JohnHurley16/RoboArm/docs/images/actuator_section.png

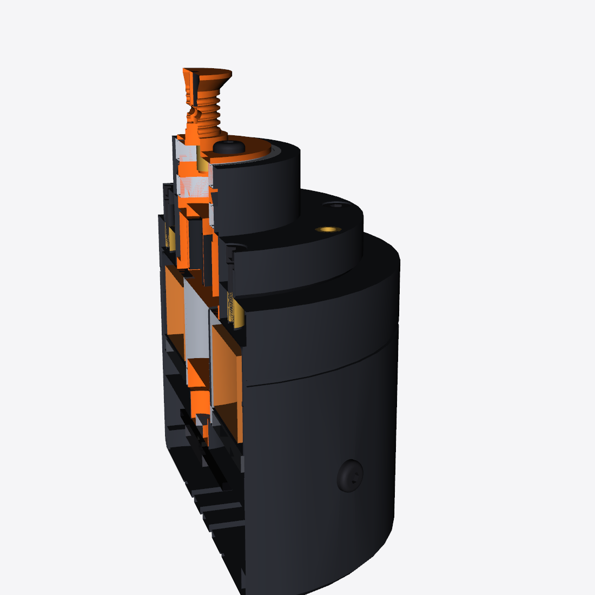
docs/images/actuator_section.png
