JohnHurley16/RoboArm/docs/images/balancer_cutaway.png

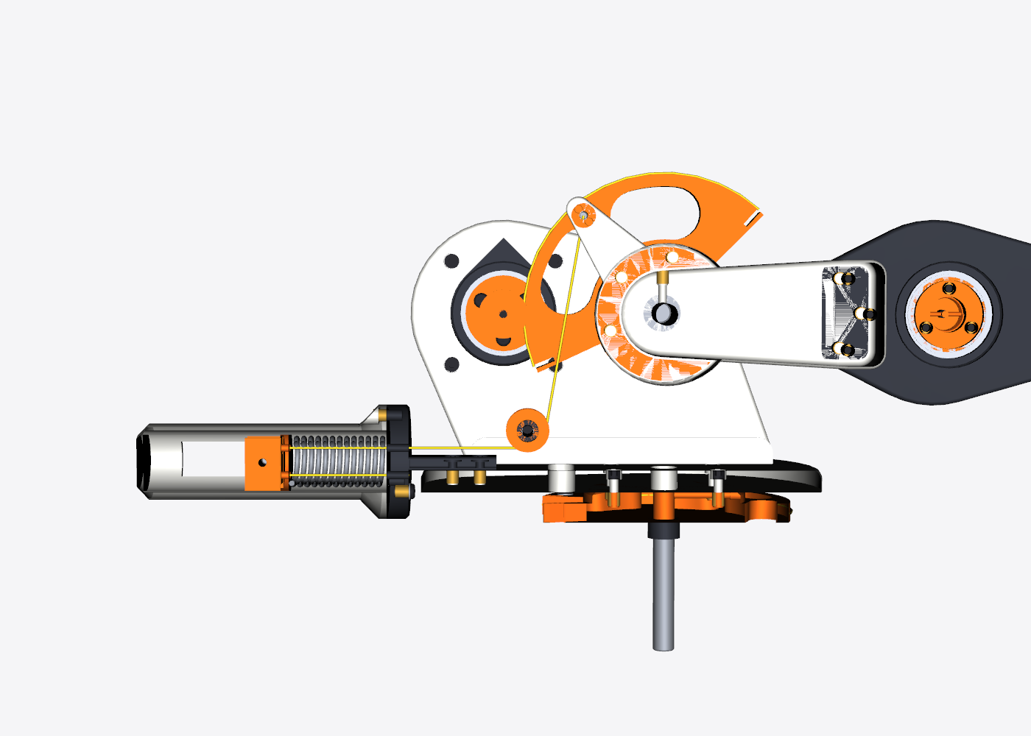
docs/images/balancer_cutaway.png
