JohnHurley16/RoboArm/docs/images/final_pose_back.png

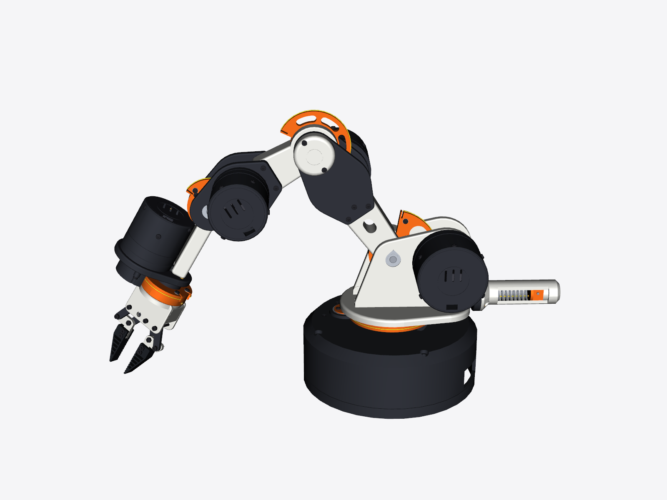
docs/images/final_pose_back.png
