JohnHurley16/RoboArm/docs/images/hand_open.png

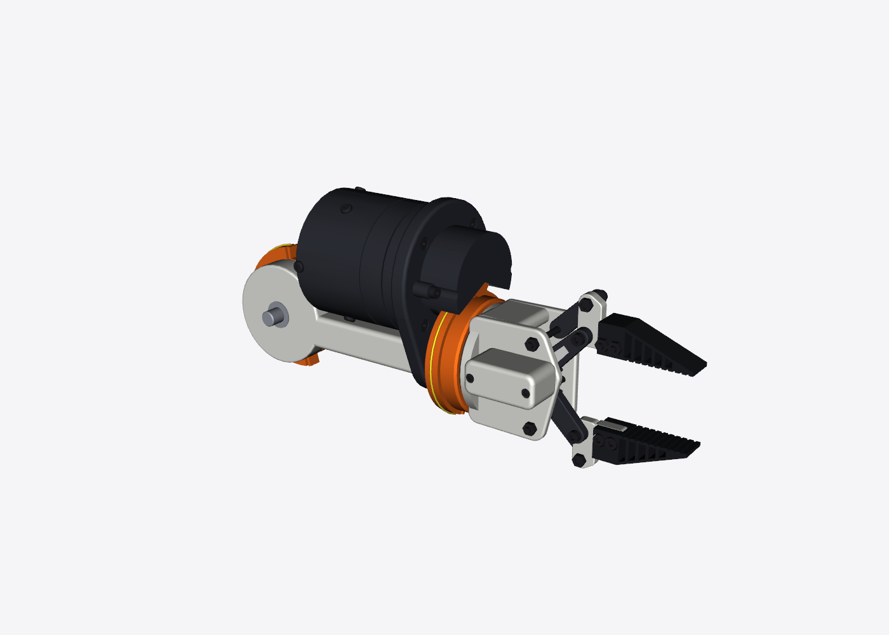
docs/images/hand_open.png
