JohnHurley16/RoboArm/docs/images/hand_rolled.png

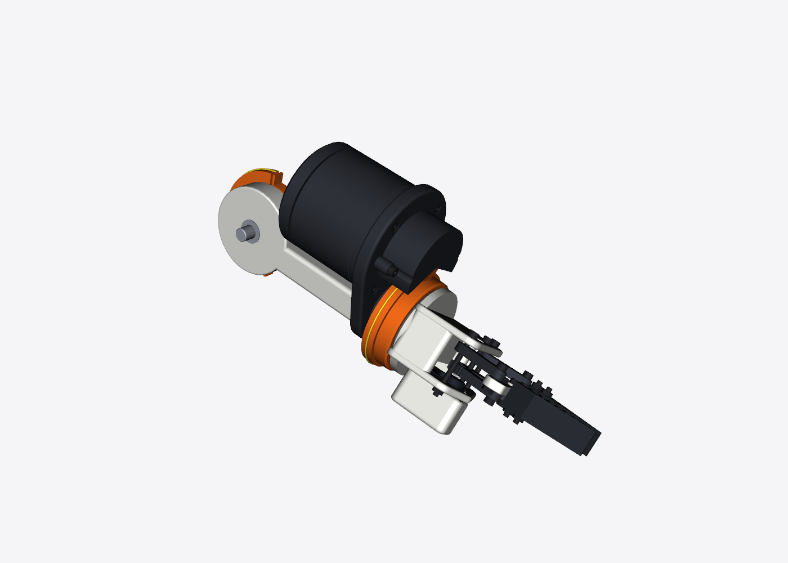
docs/images/hand_rolled.png
