JohnHurley16/RoboArm/print/plates/plates_overview.png

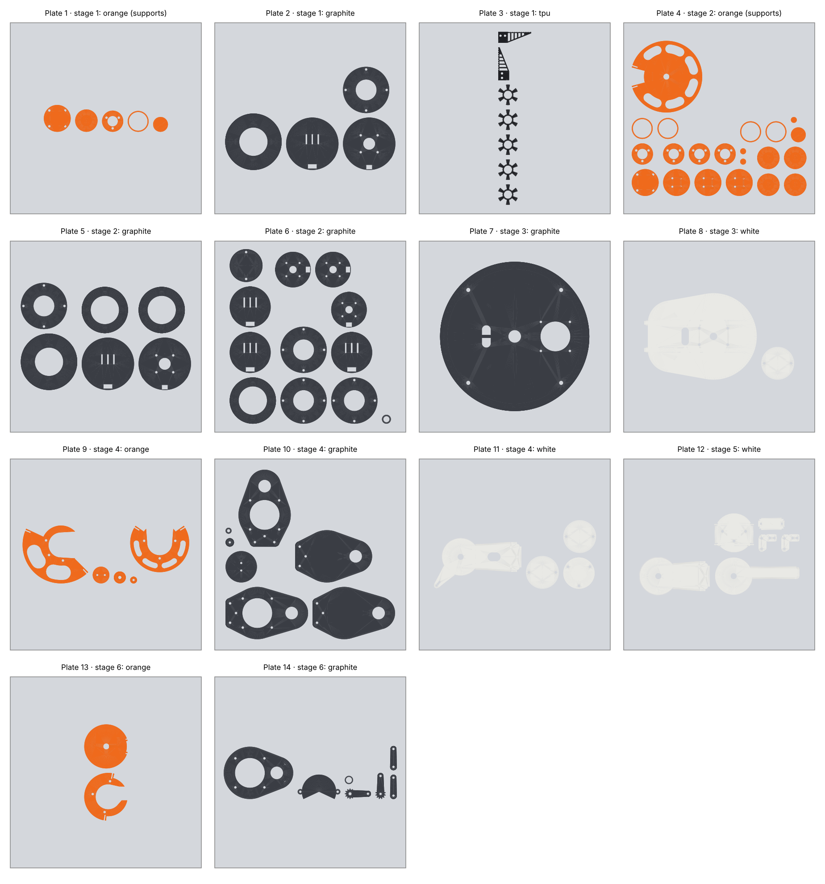
print/plates/plates_overview.png
