JohnHurley16/RoboArm/sim/out/bag_drape.png

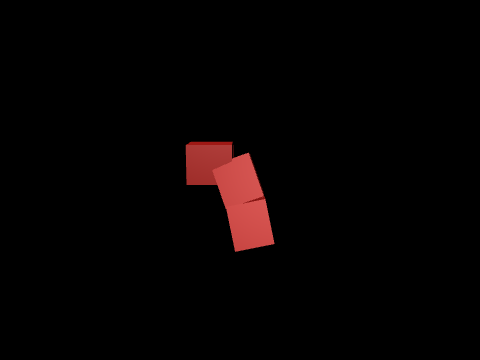
sim/out/bag_drape.png
