JohnHurley16/RoboArm/sim/out/bag_rest.png

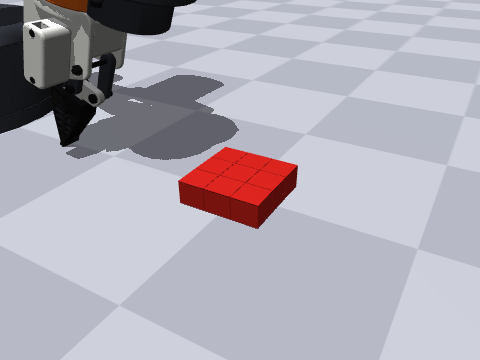
sim/out/bag_rest.png
