JohnHurley16/RoboArm/sim/out/model_check.png

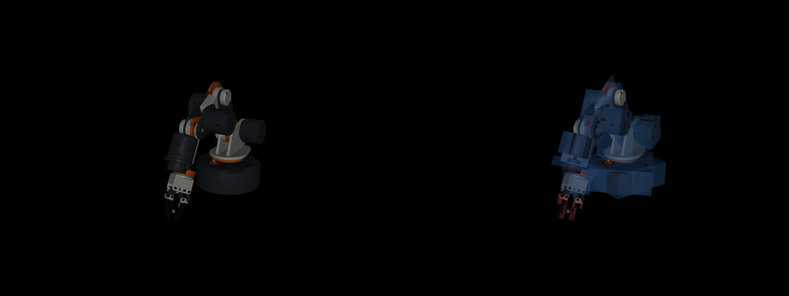
sim/out/model_check.png
