JohnHurley16/RoboArm/sim/out/pick_frames.png

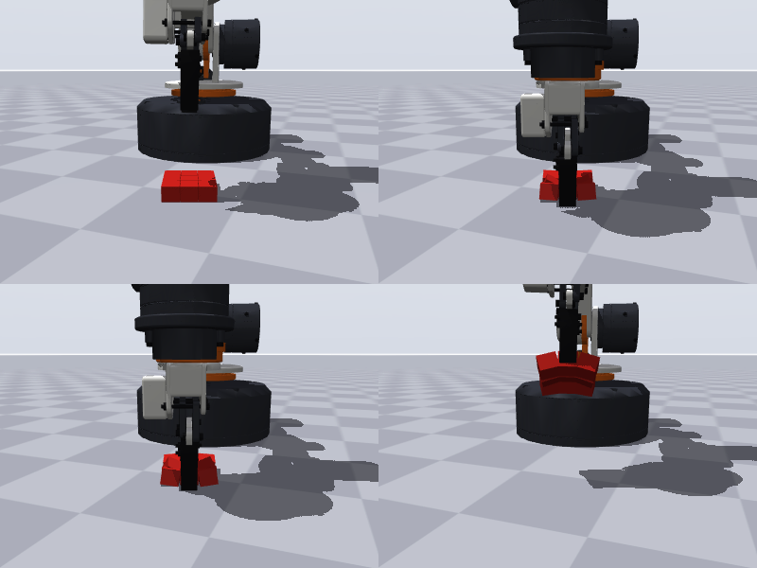
sim/out/pick_frames.png
