JohnHurley16/RoboArm/docs/BOM.md

# Bill of materials

## Printed parts

| Part | Qty | Bounding box (print orientation, mm) | Overhang >45° (mm²) |
|---|---:|---|---:|
| `base.stl` | 1 | 200 × 200 × 72 | 4209 |
| `act_front_cap.stl` | 5 | 62 × 62 × 20 | 394 |
| `act_motor_can_GL40.stl` | 3 | 62 × 62 × 52 | 231 |
| `act_rear_plate_GL40.stl` | 3 | 48 × 48 × 8 | 51 |
| `act_rear_lid_GL40.stl` | 3 | 55 × 55 × 6 | 130 |
| `act_hub.stl` | 5 | 30 × 30 × 38 | 663 |
| `act_rotor_adapter_GL40.stl` | 3 | 36 × 36 × 13 | 27 |
| `act_spider_tpu.stl` | 5 | 26 × 27 × 10 | 0 |
| `act_retainer_ring.stl` | 5 | 28 × 28 × 1 | 0 |
| `act_bearing_spacer.stl` | 5 | 28 × 28 × 3 | 0 |
| `act_magnet_plug_GL40.stl` | 3 | 8 × 8 × 12 | 0 |
| `joint_cap.stl` | 4 | 44 × 44 × 14 | 280 |
| `turret_drum.stl` | 1 | 94 × 96 × 11 | 66 |
| `turret_body.stl` | 1 | 151 × 116 × 100 | 188 |
| `j1_spacer.stl` | 1 | 12 × 12 × 7 | 0 |
| `act_motor_can_GL60.stl` | 2 | 76 × 76 × 53 | 244 |
| `act_rear_plate_GL60.stl` | 2 | 70 × 70 × 8 | 60 |
| `act_rear_lid_GL60.stl` | 2 | 70 × 70 × 6 | 130 |
| `act_rotor_adapter_GL60.stl` | 2 | 36 × 36 × 13 | 17 |
| `act_magnet_plug_GL60.stl` | 2 | 20 × 20 × 12 | 0 |
| `balancer_idler.stl` | 1 | 16 × 16 × 5 | 72 |
| `balancer_spacer.stl` | 1 | 8 × 8 × 4 | 0 |
| `balancer_bracket.stl` | 1 | 42 × 42 × 40 | 75 |
| `balancer_tube.stl` | 1 | 42 × 42 × 92 | 392 |
| `upper_arm.stl` | 1 | 118 × 69 × 27 | 191 |
| `balancer_spool.stl` | 1 | 9 × 9 × 3 | 43 |
| `sector_j2.stl` | 1 | 88 × 78 × 7 | 0 |
| `upper_arm_cheek_a.stl` | 1 | 111 × 70 × 9 | 141 |
| `upper_arm_cheek_b.stl` | 1 | 111 × 70 × 9 | 166 |
| `forearm.stl` | 1 | 95 × 52 × 27 | 179 |
| `sector_j3.stl` | 1 | 62 × 79 × 7 | 0 |
| `forearm_cheek_a.stl` | 1 | 103 × 70 × 9 | 137 |
| `forearm_cheek_b.stl` | 1 | 103 × 70 × 9 | 162 |
| `hand.stl` | 1 | 114 × 52 × 27 | 246 |
| `sector_j4.stl` | 1 | 58 × 64 × 7 | 0 |
| `wrist_yoke.stl` | 1 | 93 × 70 × 22 | 98 |
| `roll_pulley_guard.stl` | 1 | 33 × 57 × 20 | 56 |
| `roll_spacer.stl` | 1 | 11 × 11 × 7 | 0 |
| `roll_flange.stl` | 1 | 58 × 59 × 15 | 875 |
| `palm.stl` | 1 | 53 × 52 × 47 | 330 |
| `servo_cover.stl` | 1 | 35 × 16 × 20 | 103 |
| `link_drive_upper.stl` | 1 | 35 × 14 × 5 | 0 |
| `link_drive_lower.stl` | 1 | 35 × 14 × 5 | 0 |
| `link_follow.stl` | 2 | 33 × 9 × 5 | 0 |
| `finger.stl` | 2 | 25 × 24 × 5 | 0 |
| `finray_tpu.stl` | 2 | 44 × 15 × 14 | 102 |
| `balancer_piston.stl` | 1 | 22 × 22 × 16 | 7 |
| `balancer_piston_pulley.stl` | 1 | 11 × 11 × 3 | 11 |

Estimated filament: ~1111 g PETG (4 walls, 25-35 % gyroid).

## Purchased parts

| Item | Qty |
|---|---:|
| 608 bearing (8x22x7) | 10 |
| 6705 bearing (25x32x4) | 10 |
| 684ZZ bearing (4x9x4) | 1 |
| 8 mm e-clip (DIN 6799) | 1 |
| 8 mm steel shaft x 30 mm | 1 |
| 8 mm steel shaft x 44 mm (h6 / linear rod) | 3 |
| 8 mm steel shaft x 60 mm | 1 |
| AS5047P encoder breakout (joint encoder, to the driver aux port) | 4 |
| Compression spring, music wire 2.2 mm, OD 21 mm, free length 78 mm, ~3.2 N/mm, ends closed & ground | 1 |
| CubeMars GL40 KV70 | 3 |
| CubeMars GL60 KV25 | 2 |
| Diametric magnet 6x2.5 mm | 4 |
| Dowel pin 3x12 (piston pulley) | 1 |
| Dowel pin 3x8 (balancer ear) | 1 |
| M2 heat-set insert | 20 |
| M2.5x5 button head (rotor adapter; check max depth on the drawing) | 12 |
| M2.5x6 socket head (motor to plate; check max depth on the drawing) | 12 |
| M2x20 self-tapping screw (servo) | 2 |
| M2x5 socket head (driver) | 20 |
| M2x6 self-tapping screw (encoder board) | 8 |
| M3 heat-set insert (M3x5.7, 4.6 OD) | 145 |
| M3 nyloc nut | 11 |
| M3 washer (cable clamp) | 11 |
| M3x10 socket head | 38 |
| M3x10 socket head (actuator mount) | 20 |
| M3x12 socket head | 2 |
| M3x12 socket head (finger pin) | 4 |
| M3x16 socket head (fingertip) | 4 |
| M3x16 socket head (joint cap) | 8 |
| M3x35 socket head (palm pivot) | 3 |
| M3x5 button head (rotor adapter; check max depth on the drawing) | 8 |
| M3x6 button head (cable clamp) | 11 |
| M3x6 button head (can) | 30 |
| M3x6 button head (retainer) | 15 |
| M3x6 grub screw (pulley cable clamp) | 5 |
| M3x6 socket head (motor to plate; check max depth on the drawing) | 8 |
| M3x8 button head | 5 |
| M3x8 grub screw (shaft lock) | 4 |
| M3x8 socket head | 3 |
| M3x8 socket head (sector) | 9 |
| M4 nyloc nut | 1 |
| M4x20 socket head (balancer idler) | 1 |
| M8 shim washer 8x14x0.5 | 7 |
| MG90S metal-gear micro servo | 1 |
| mjbots moteus-c1 motor driver | 5 |
| Dyneema / UHMWPE braid Ø1 mm, J1: 501 mm (incl. 2×40 mm tails) | 1 |
| Dyneema / UHMWPE braid Ø1 mm, J2: 367 mm (incl. 2×40 mm tails) | 1 |
| Dyneema / UHMWPE braid Ø1 mm, J3: 396 mm (incl. 2×40 mm tails) | 1 |
| Dyneema / UHMWPE braid Ø1 mm, J4: 329 mm (incl. 2×40 mm tails) | 1 |
| Dyneema / UHMWPE braid Ø1 mm, J5: 394 mm (incl. 2×40 mm tails) | 1 |
| Dyneema / UHMWPE braid Ø1 mm, shoulder balancer: 410 mm (incl. tails) | 1 |
