JohnHurley16/RoboArm/print/step/arm_assembly.step

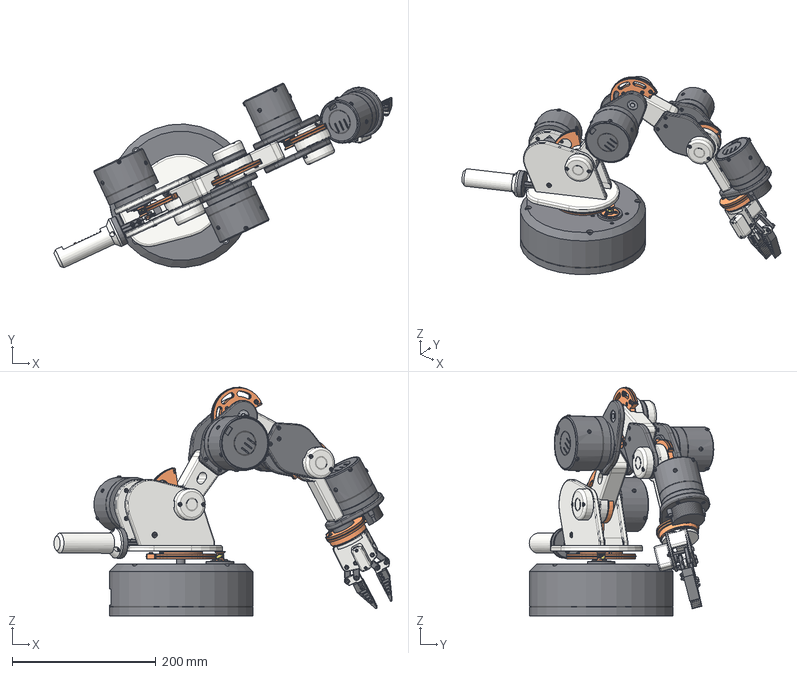
[picture p13: CAD file, 2026-10-08]
print/step/arm_assembly.step
470.5 x 257.0 x 318.3 mm
base__base__0
base__act_front_cap__1 x 3
base__act_motor_can_GL40__2 x 3
base__act_rear_plate_GL40__3 x 3
base__act_rear_lid_GL40__4 x 3
base__act_hub__5 x 3
base__act_rotor_adapter_GL40__6 x 3
base__act_spider_tpu__7 x 3
base__act_retainer_ring__8 x 3
base__act_bearing_spacer__9 x 3
base__act_magnet_plug_GL40__10 x 3
base__motor_base__11 x 3
base__motor_bell__12 x 3
base__motor_shaft__13 x 3
base__motor_stator__14 x 3
base__motor_wires__15 x 3
base__drv_pcb__16 x 3
base__drv_parts__17 x 3
base__drv_chip__18 x 3
base__magnet_drv__19 x 3
base__brg_6705__20 x 3
base__brg_6705__21 x 3
base__ins_m3__22 x 3
base__shcs_m3x10__23 x 3
base__ins_m3__24 x 3
base__shcs_m3x10__25 x 3
base__ins_m3__26 x 3
base__shcs_m3x10__27 x 3
base__ins_m3__28 x 3
base__shcs_m3x10__29 x 3
base__ins_m3__30 x 3
base__ins_m3__31 x 3
base__ins_m3__32 x 3
base__ins_m3__33 x 3
base__ins_m3__34 x 3
base__bhcs_m3x6__35 x 3
base__ins_m3__36 x 3
base__bhcs_m3x6__37 x 3
base__ins_m3__38 x 3
base__bhcs_m3x6__39 x 3
base__grub_m3x6__40 x 3
base__ins_m3__41 x 3
base__bhcs_m3x6__42 x 3
base__ins_m3__43 x 3
base__bhcs_m3x6__44 x 3
base__ins_m3__45 x 3
base__bhcs_m3x6__46 x 3
base__ins_m3__47 x 3
base__bhcs_m3x6__48 x 3
base__ins_m3__49 x 3
base__bhcs_m3x6__50 x 3
base__ins_m3__51 x 3
base__bhcs_m3x6__52 x 3
base__motor_screw__53 x 3
base__motor_screw__54 x 3
base__motor_screw__55 x 3
base__motor_screw__56 x 3
base__motor_screw__57 x 3
base__motor_screw__58 x 3
base__motor_screw__59 x 3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
