JohnHurley16/RoboArm/print/mini/capstan_arm_mini.3mf

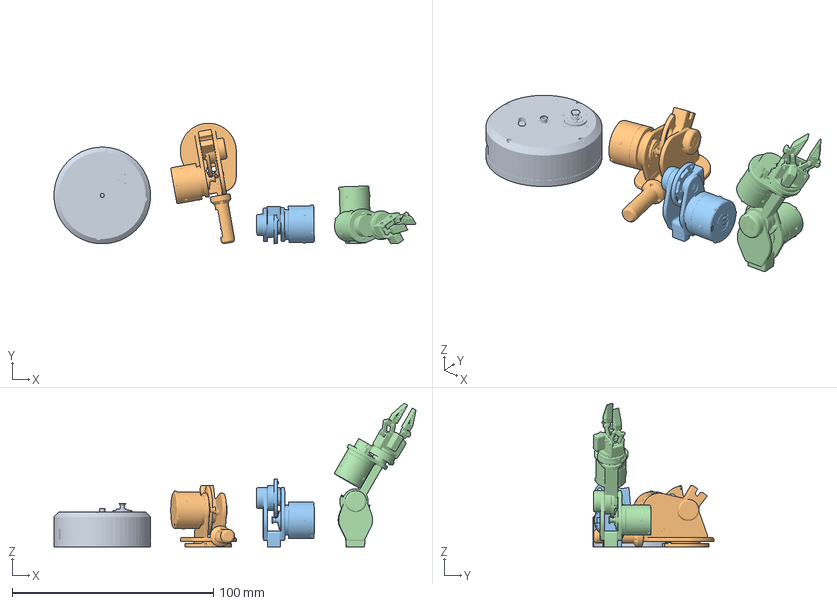
[picture p14: CAD file, 2026-10-08]
print/mini/capstan_arm_mini.3mf
179.9 x 59.9 x 71.3 mm
A_base
B_shoulder
C_elbow
D_wrist
