JohnHurley16/RoboArm/print/plates/plate_07_s3_graphite.3mf

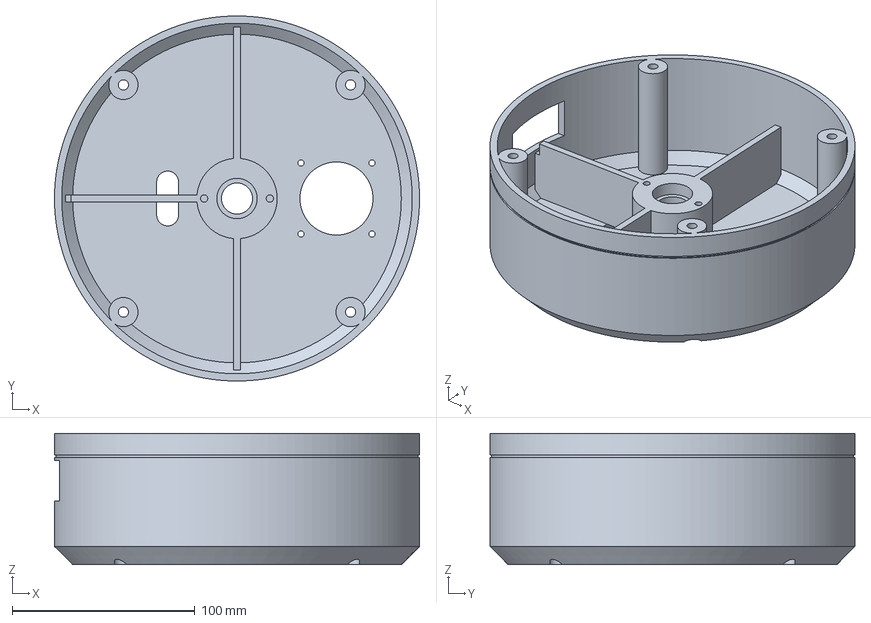
[picture p15: CAD file, 2026-10-08]
print/plates/plate_07_s3_graphite.3mf
200.0 x 199.9 x 72.0 mm
