JohnHurley16/RoboArm/print/stl/roll_flange.stl

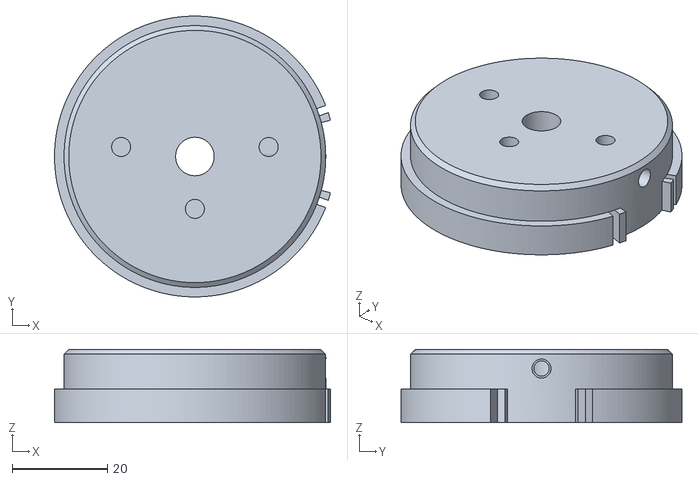
[picture p17: CAD file, 2026-10-08]
print/stl/roll_flange.stl
58.0 x 59.0 x 15.4
