JohnHurley16/RoboArm/sim/assets/meshes/l1u_graphite.stl

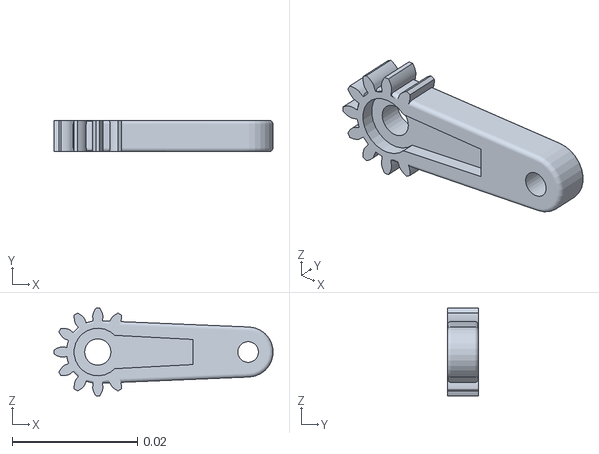
[picture p18: CAD file, 2026-10-08]
sim/assets/meshes/l1u_graphite.stl
0.035 x 0.005 x 0.014
