JohnHurley16/RoboArm/print/plates/plate_04_s2_orange_supports.3mf

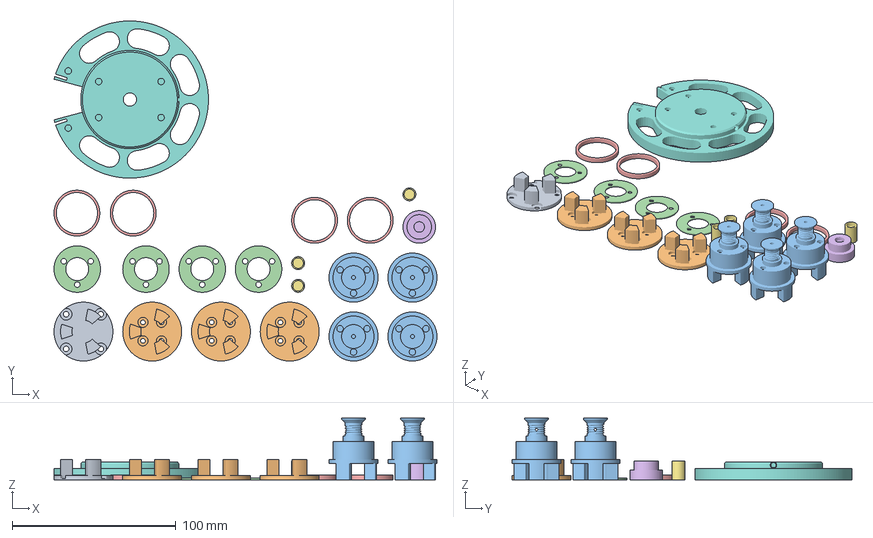
[picture p19: CAD file, 2026-10-08]
print/plates/plate_04_s2_orange_supports.3mf
234.0 x 207.8 x 37.6 mm
act_rotor_adapter_GL60
act_rotor_adapter_GL40 x 3
act_hub x 4
act_retainer_ring x 4
act_bearing_spacer x 4
act_magnet_plug_GL60
act_magnet_plug_GL40 x 3
turret_drum
