JohnHurley16/RoboArm/print/stl/act_magnet_plug_GL40.stl

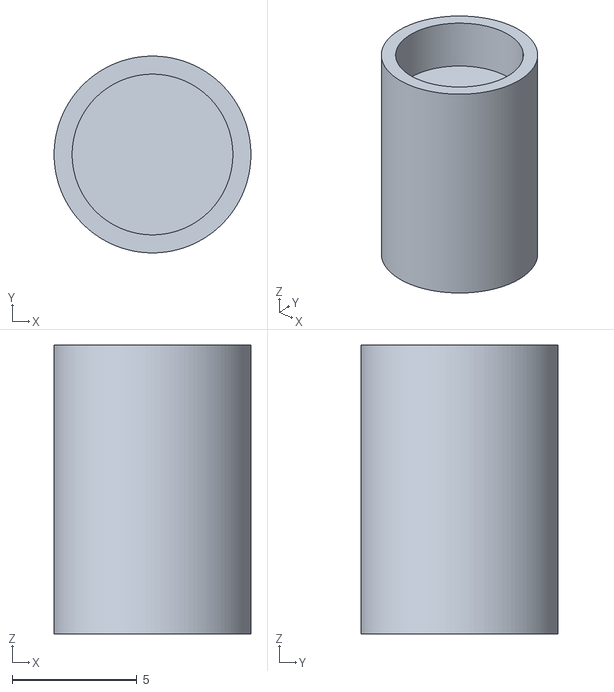
[picture p20: CAD file, 2026-10-08]
print/stl/act_magnet_plug_GL40.stl
7.90 x 7.90 x 11.6
