JohnHurley16/RoboArm/sim/assets/meshes/hand_steel.stl

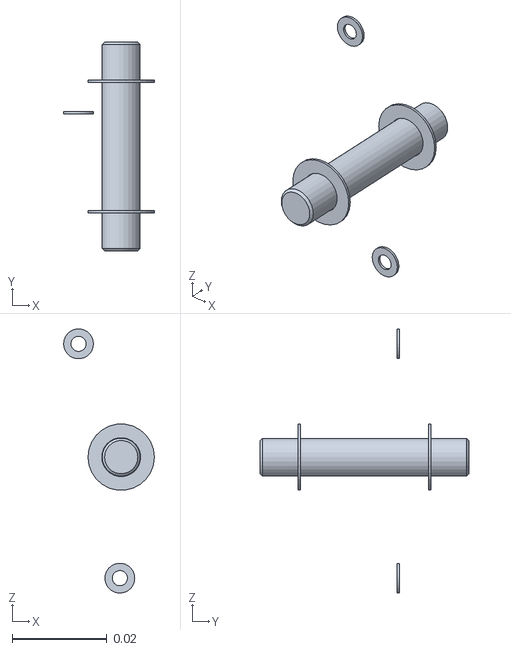
[picture p21: CAD file, 2026-10-08]
sim/assets/meshes/hand_steel.stl
0.0191 x 0.044 x 0.0556
