JohnHurley16/RoboArm/print/plates/plate_13_s6_orange.3mf

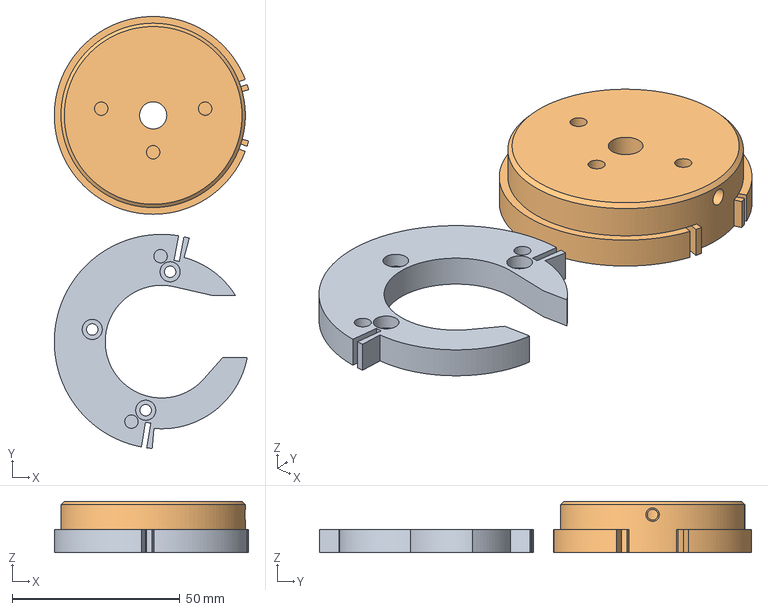
[picture p22: CAD file, 2026-10-08]
print/plates/plate_13_s6_orange.3mf
58.0 x 128.9 x 15.3 mm
sector_j4
roll_flange
