JohnHurley16/RoboArm/print/step/actuator_GL60.step

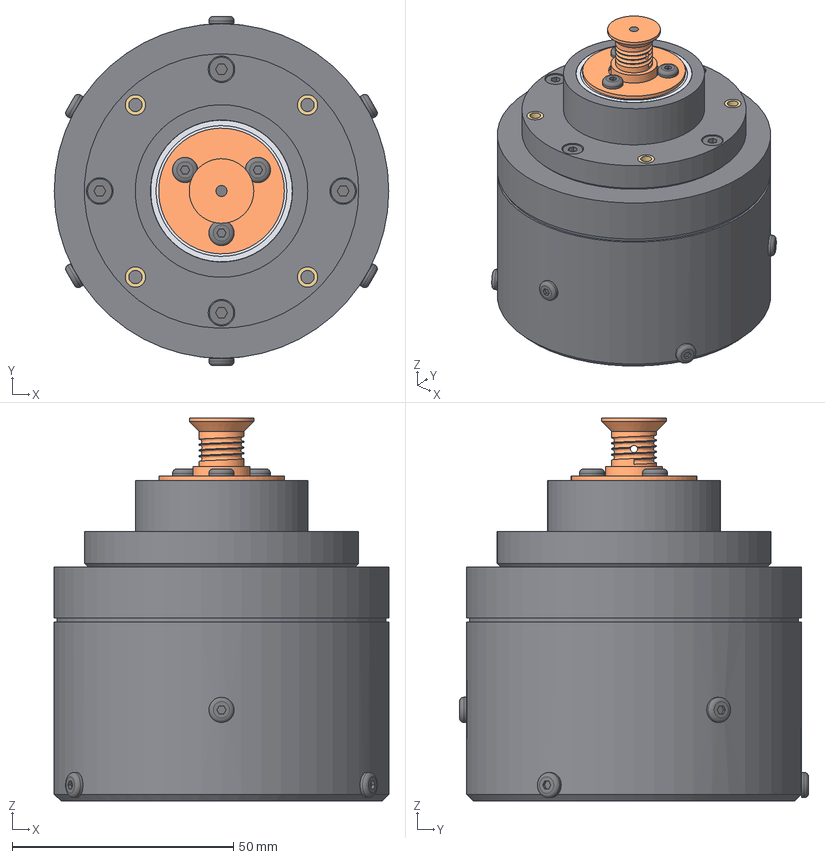
[picture p23: CAD file, 2026-10-08]
print/step/actuator_GL60.step
75.6 x 78.9 x 86.5 mm
act_front_cap__0
act_motor_can_GL60__1
act_rear_plate_GL60__2
act_rear_lid_GL60__3
act_hub__4
act_rotor_adapter_GL60__5
act_spider_tpu__6
act_retainer_ring__7
act_bearing_spacer__8
act_magnet_plug_GL60__9
motor_base__10
motor_bell__11
motor_shaft__12
motor_stator__13
motor_wires__14
drv_pcb__15
drv_parts__16
drv_chip__17
magnet_drv__18
brg_6705__19
brg_6705__20
ins_m3__21
shcs_m3x10__22
ins_m3__23
shcs_m3x10__24
ins_m3__25
shcs_m3x10__26
ins_m3__27
shcs_m3x10__28
ins_m3__29
ins_m3__30
ins_m3__31
ins_m3__32
ins_m3__33
bhcs_m3x6__34
ins_m3__35
bhcs_m3x6__36
ins_m3__37
bhcs_m3x6__38
grub_m3x6__39
ins_m3__40
bhcs_m3x6__41
ins_m3__42
bhcs_m3x6__43
ins_m3__44
bhcs_m3x6__45
ins_m3__46
bhcs_m3x6__47
ins_m3__48
bhcs_m3x6__49
ins_m3__50
bhcs_m3x6__51
motor_screw__52
motor_screw__53
motor_screw__54
motor_screw__55
motor_screw__56
motor_screw__57
motor_screw__58
motor_screw__59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
