JohnHurley16/RoboArm/print/stl/act_motor_can_GL60.stl

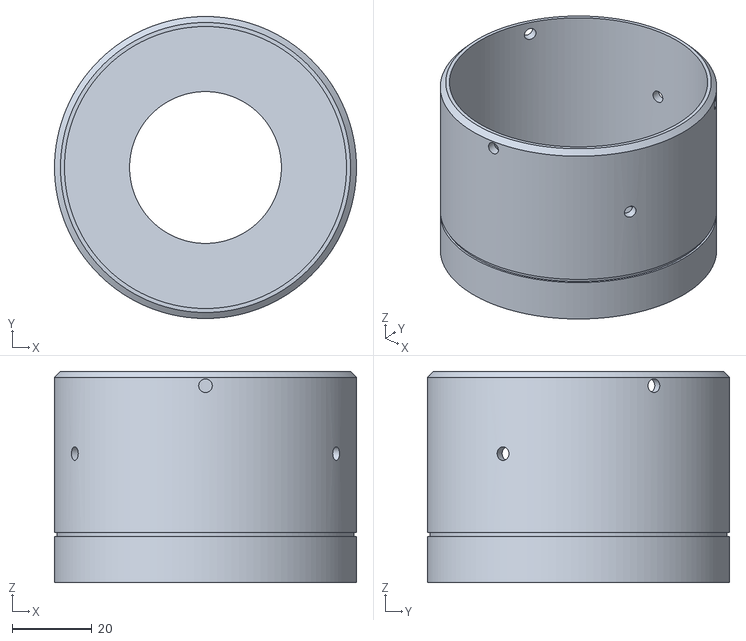
[picture p24: CAD file, 2026-10-08]
print/stl/act_motor_can_GL60.stl
75.6 x 75.6 x 52.9
