JohnHurley16/RoboArm/sim/assets/meshes/base_black.stl

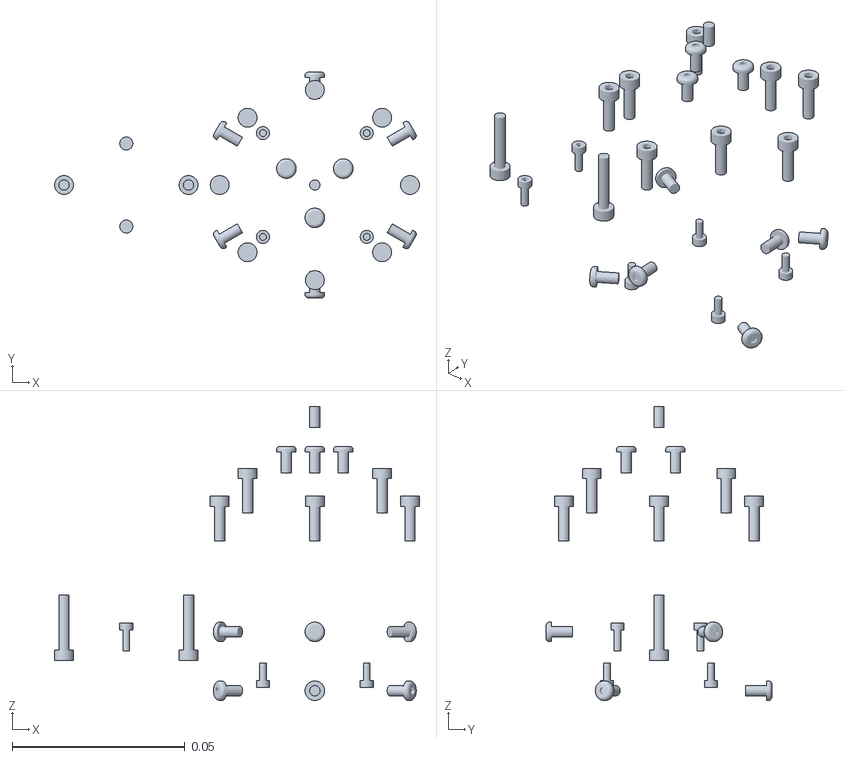
[picture p25: CAD file, 2026-10-08]
sim/assets/meshes/base_black.stl
0.105 x 0.0653 x 0.085
