JohnHurley16/RoboArm/print/plates/plate_12_s5_white.3mf

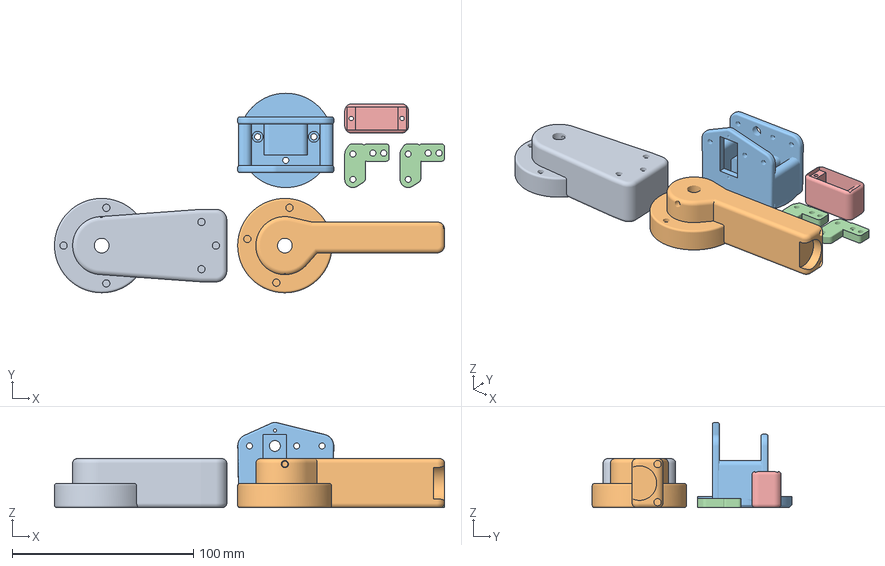
[picture p26: CAD file, 2026-10-08]
print/plates/plate_12_s5_white.3mf
215.0 x 110.0 x 47.0 mm
forearm
hand
palm
finger x 2
servo_cover
