JohnHurley16/RoboArm/print/stl/link_drive_lower.stl

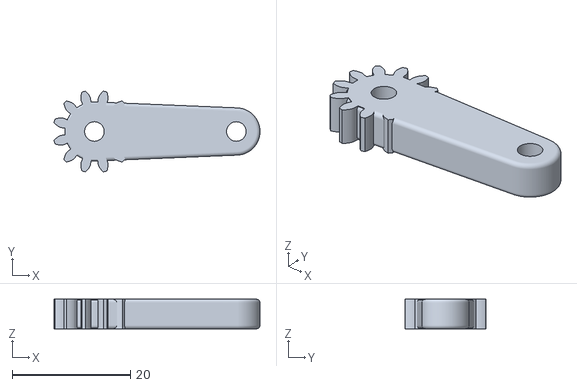
[picture p27: CAD file, 2026-10-08]
print/stl/link_drive_lower.stl
34.8 x 13.7 x 5.00
