JohnHurley16/RoboArm/sim/assets/meshes/fl_white.stl

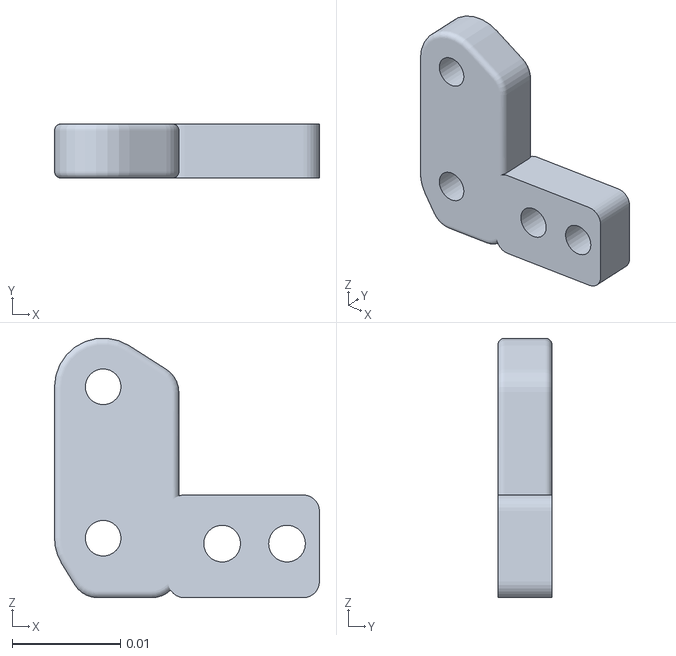
[picture p28: CAD file, 2026-10-08]
sim/assets/meshes/fl_white.stl
0.0245 x 0.005 x 0.024
