JohnHurley16/RoboArm/print/plates/plate_03_s1_tpu.3mf

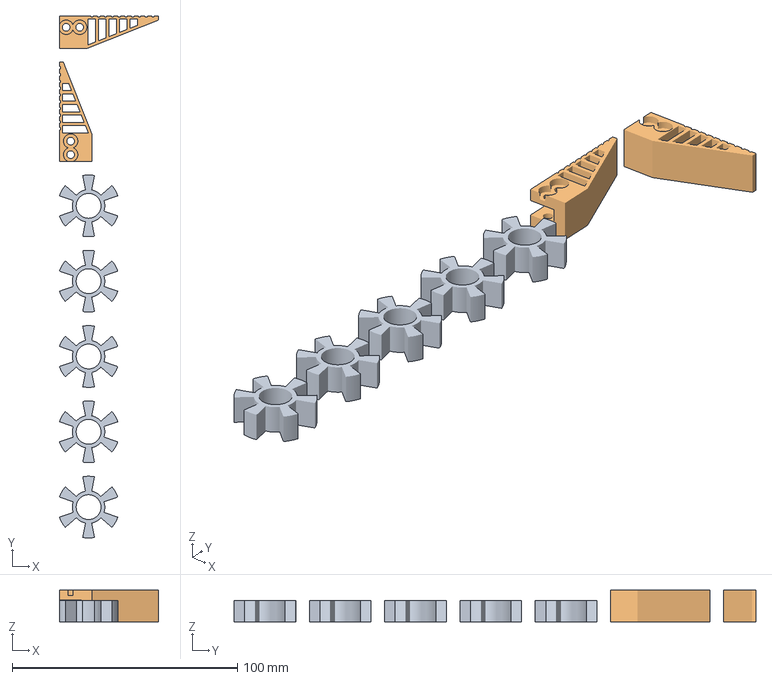
[picture p29: CAD file, 2026-10-08]
print/plates/plate_03_s1_tpu.3mf
44.0 x 231.5 x 14.0 mm
act_spider_tpu x 5
finray_tpu x 2
