JohnHurley16/RoboArm/print/stl/balancer_spool.stl

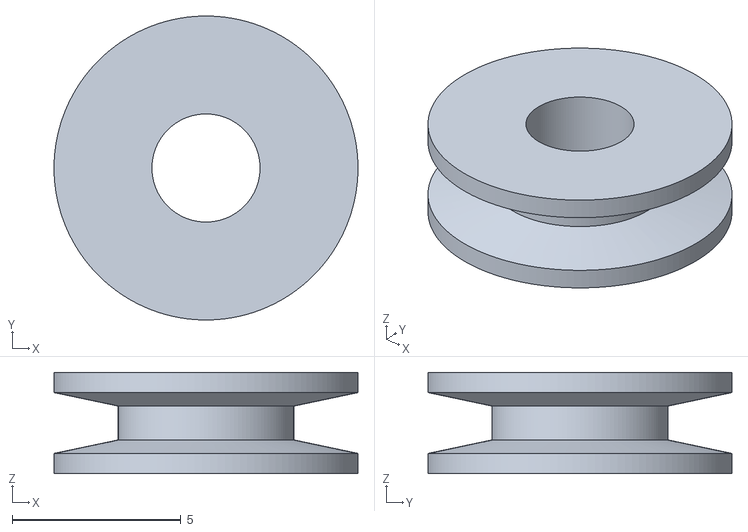
[picture p30: CAD file, 2026-10-08]
print/stl/balancer_spool.stl
9.00 x 9.00 x 3.00
