JohnHurley16/RoboArm/sim/assets/meshes/fore_graphite.stl

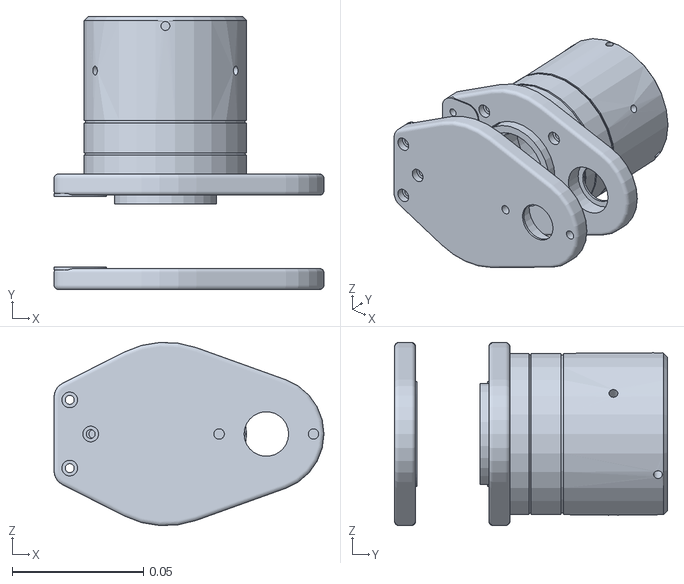
[picture p31: CAD file, 2026-10-08]
sim/assets/meshes/fore_graphite.stl
0.103 x 0.104 x 0.0699
