JohnHurley16/RoboArm/print/plates/plate_01_s1_orange_supports.3mf

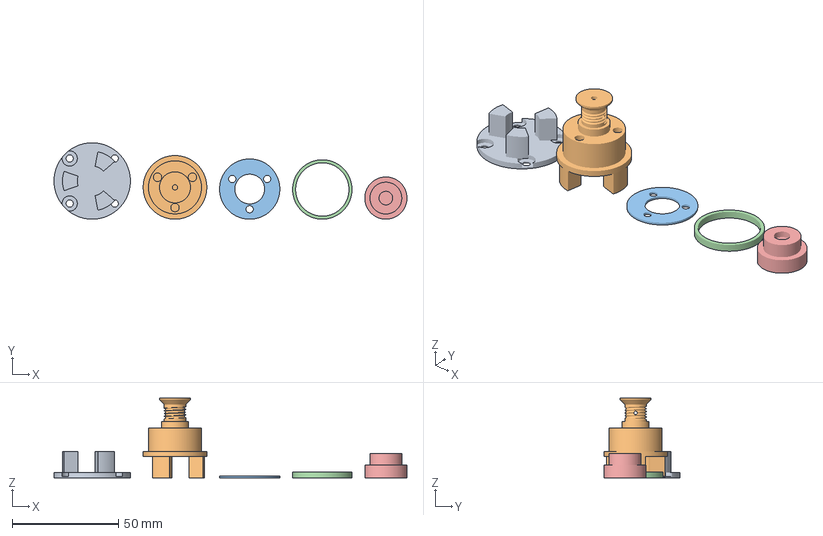
[picture p32: CAD file, 2026-10-08]
print/plates/plate_01_s1_orange_supports.3mf
166.3 x 36.0 x 37.6 mm
act_rotor_adapter_GL60
act_hub
act_retainer_ring
act_bearing_spacer
act_magnet_plug_GL60
