JohnHurley16/RoboArm/print/stl/roll_pulley_guard.stl

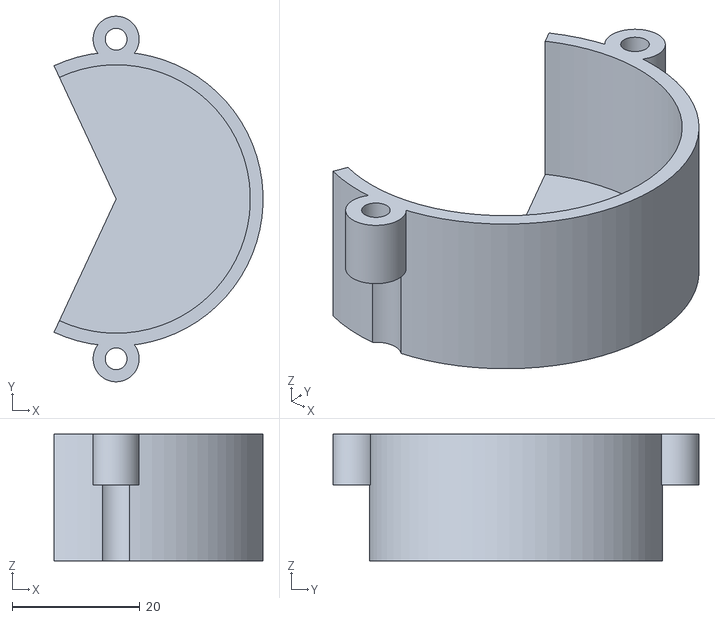
[picture p33: CAD file, 2026-10-08]
print/stl/roll_pulley_guard.stl
32.7 x 57.2 x 19.9
