JohnHurley16/RoboArm/sim/assets/meshes/hand_white.stl

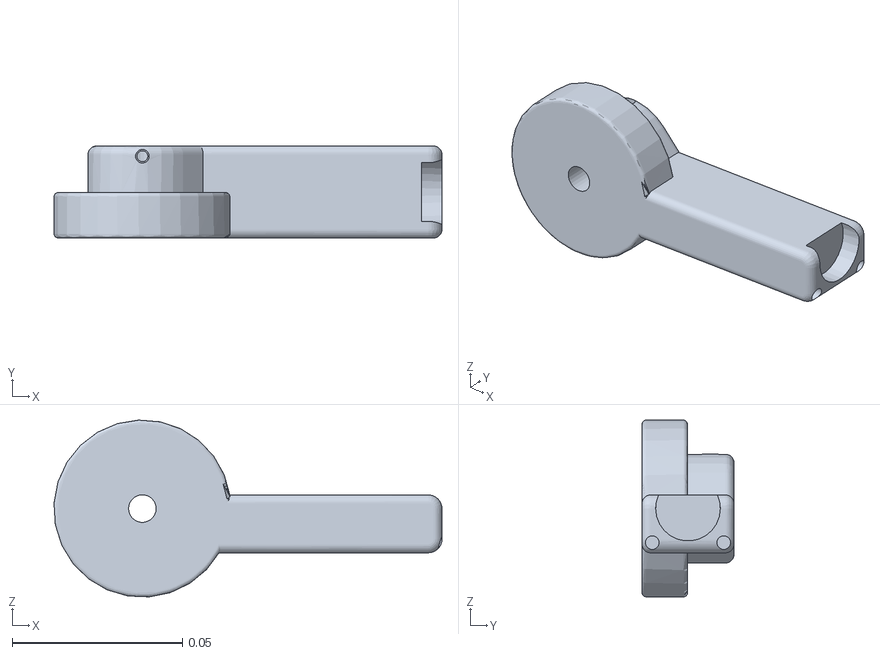
[picture p34: CAD file, 2026-10-08]
sim/assets/meshes/hand_white.stl
0.114 x 0.027 x 0.0519
