JohnHurley16/RoboArm/print/plates/plate_11_s4_white.3mf

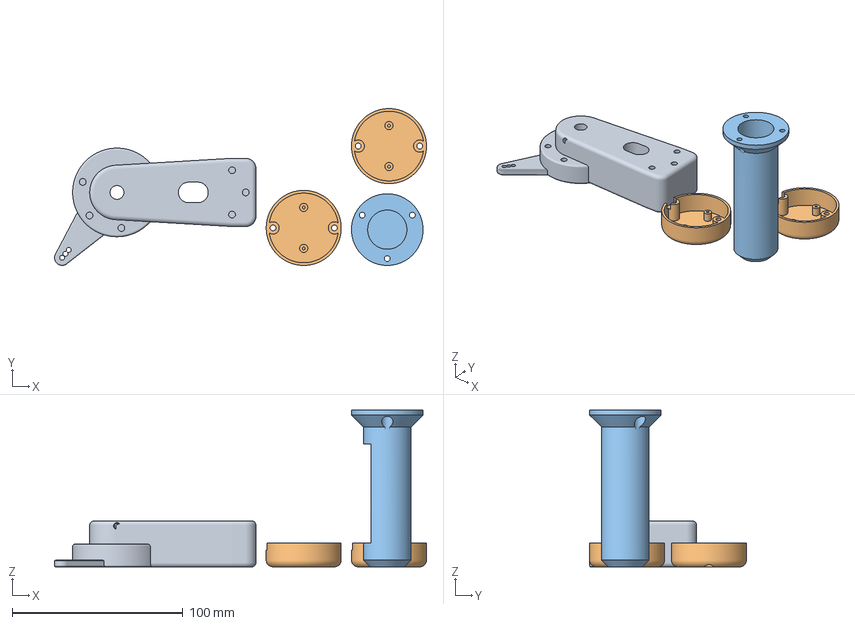
[picture p35: CAD file, 2026-10-08]
print/plates/plate_11_s4_white.3mf
218.1 x 92.0 x 92.0 mm
upper_arm
joint_cap x 2
balancer_tube
