JohnHurley16/RoboArm/print/stl/forearm.stl

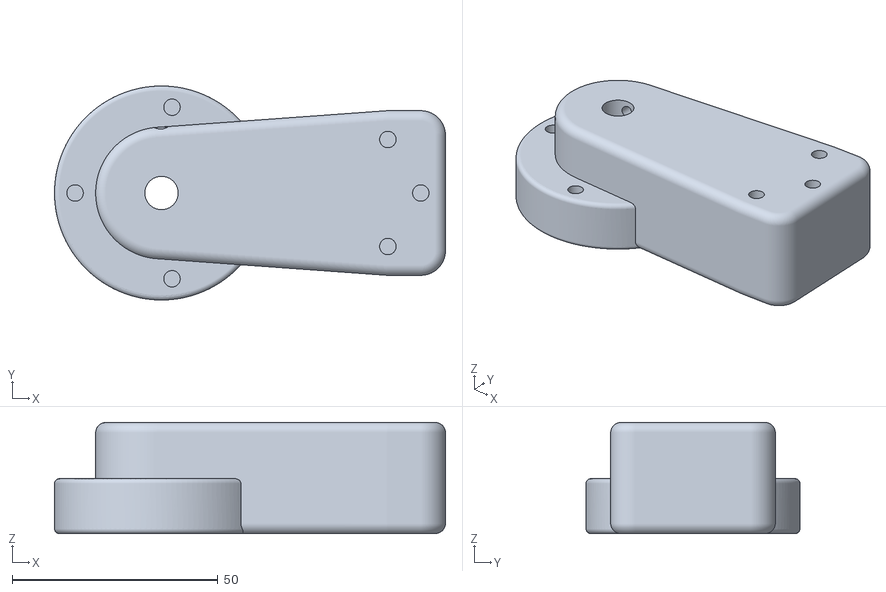
[picture p36: CAD file, 2026-10-08]
print/stl/forearm.stl
95.0 x 52.0 x 27.0
