JohnHurley16/RoboArm/sim/assets/meshes/turret_steel.stl

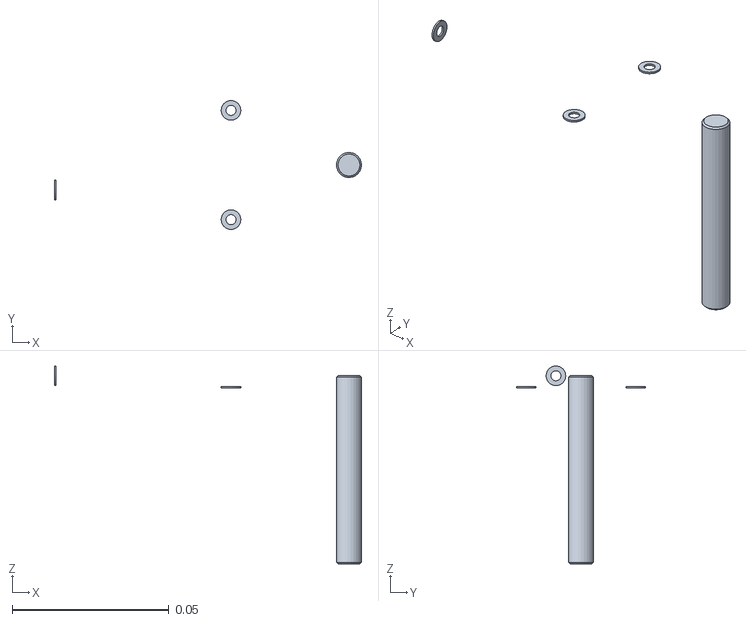
[picture p37: CAD file, 2026-10-08]
sim/assets/meshes/turret_steel.stl
0.098 x 0.0411 x 0.0632
