JohnHurley16/RoboArm/print/plates/plate_06_s2_graphite.3mf

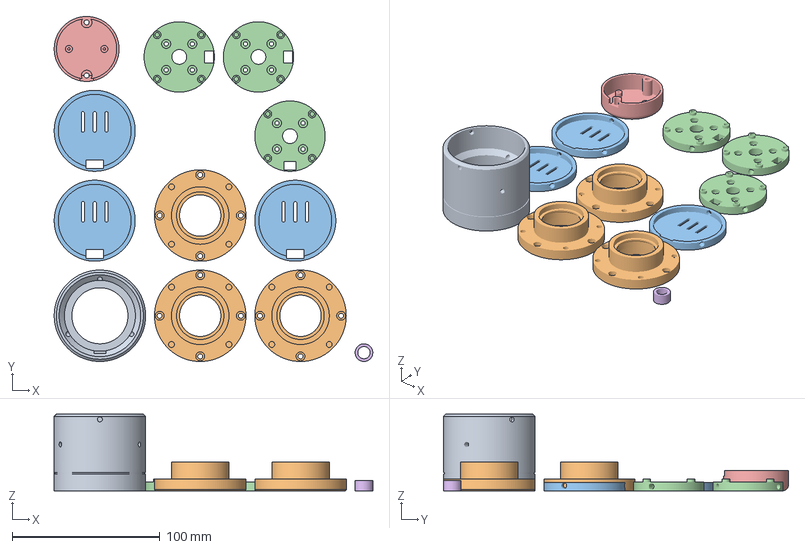
[picture p38: CAD file, 2026-10-08]
print/plates/plate_06_s2_graphite.3mf
216.0 x 233.9 x 52.1 mm
act_motor_can_GL40
act_front_cap x 3
act_rear_lid_GL40 x 3
act_rear_plate_GL40 x 3
joint_cap
j1_spacer
