JohnHurley16/RoboArm/sim/assets/meshes/l1u_steel.stl

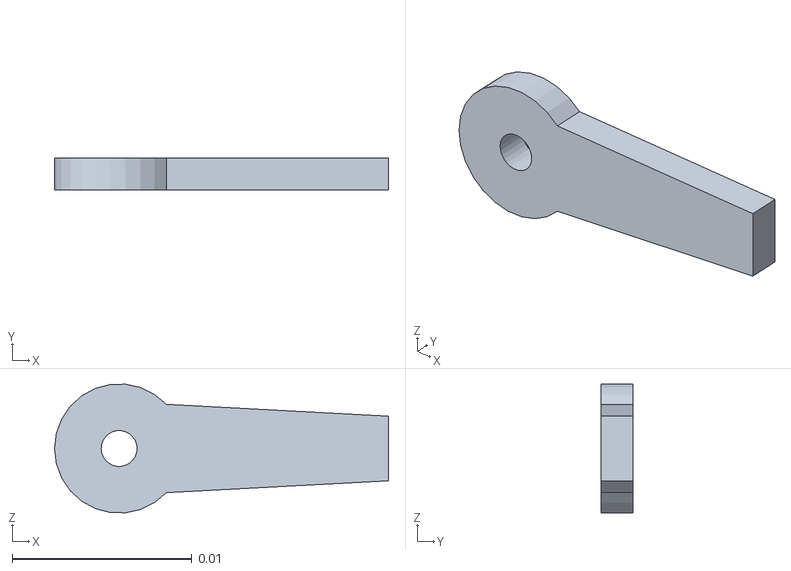
[picture p40: CAD file, 2026-10-08]
sim/assets/meshes/l1u_steel.stl
0.0186 x 0.0018 x 0.00716
