JohnHurley16/RoboArm/print/plates/plate_10_s4_graphite.3mf

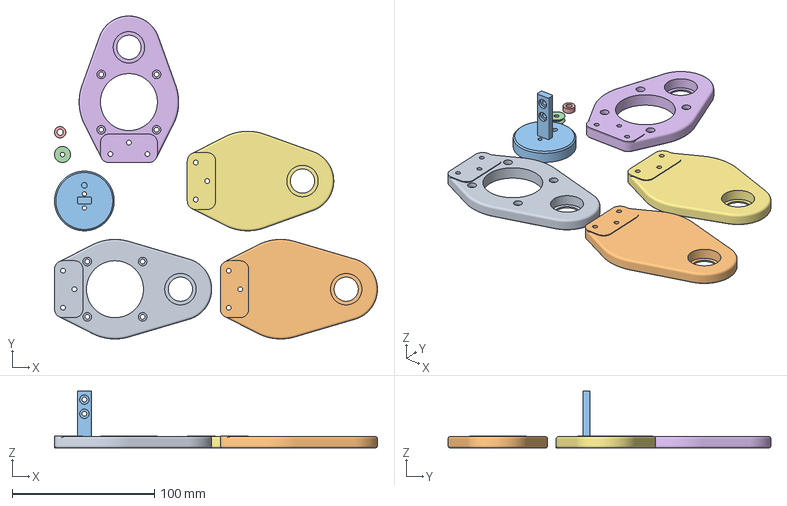
[picture p41: CAD file, 2026-10-08]
print/plates/plate_10_s4_graphite.3mf
227.0 x 227.0 x 40.0 mm
upper_arm_cheek_a
upper_arm_cheek_b
balancer_bracket
balancer_piston_pulley
balancer_spacer
forearm_cheek_a
forearm_cheek_b
