JohnHurley16/RoboArm/print/stl/wrist_yoke.stl

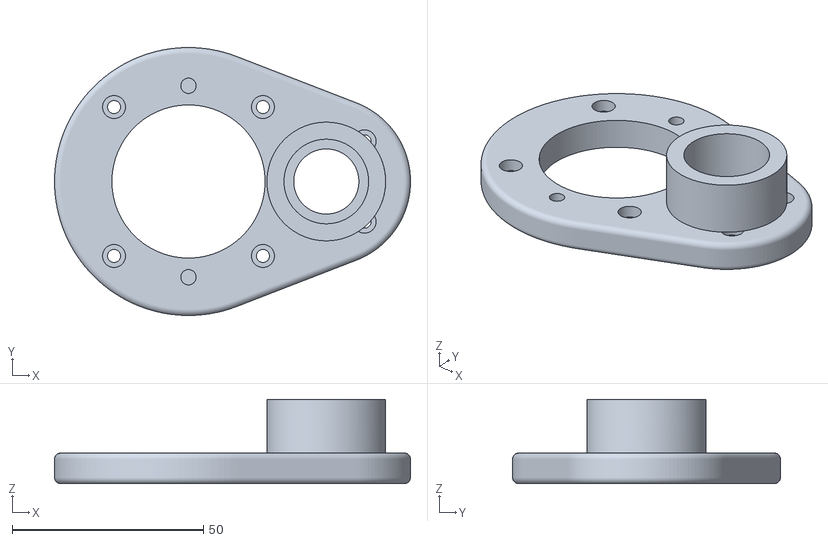
[picture p42: CAD file, 2026-10-08]
print/stl/wrist_yoke.stl
93.0 x 70.0 x 22.0
