JohnHurley16/RoboArm/sim/assets/meshes/hand_orange.stl

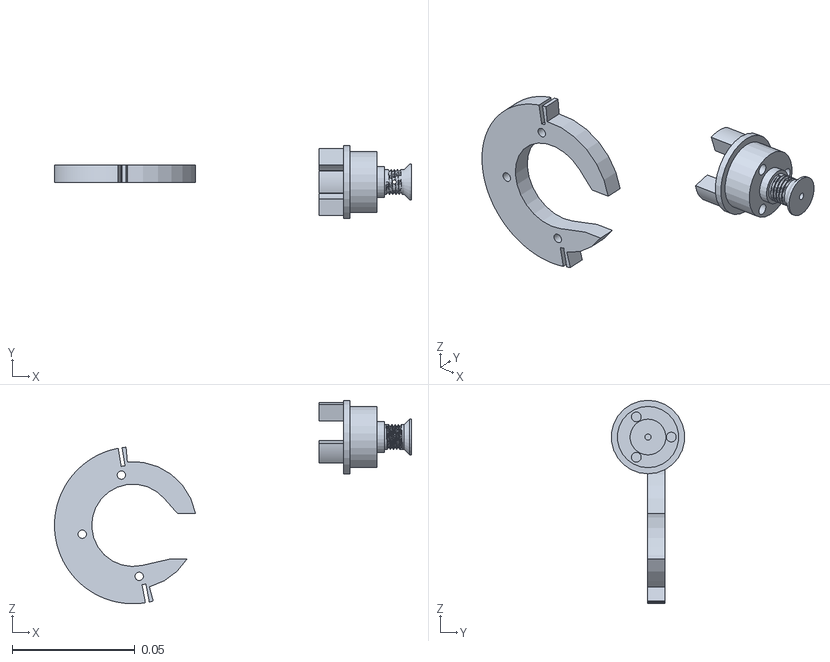
[picture p43: CAD file, 2026-10-08]
sim/assets/meshes/hand_orange.stl
0.146 x 0.0298 x 0.083
