JohnHurley16/RoboArm/print/plates/plate_09_s4_orange.3mf

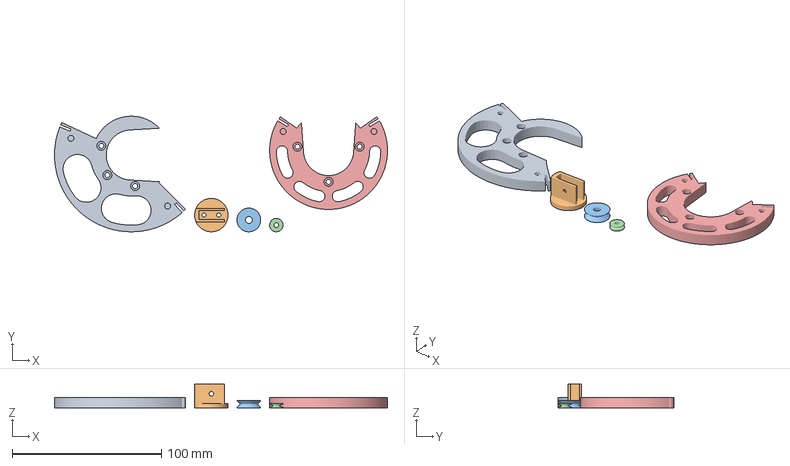
[picture p44: CAD file, 2026-10-08]
print/plates/plate_09_s4_orange.3mf
223.2 x 77.5 x 16.0 mm
sector_j2
balancer_piston
balancer_idler
balancer_spool
sector_j3
