JohnHurley16/RoboArm/print/stl/act_bearing_spacer.stl

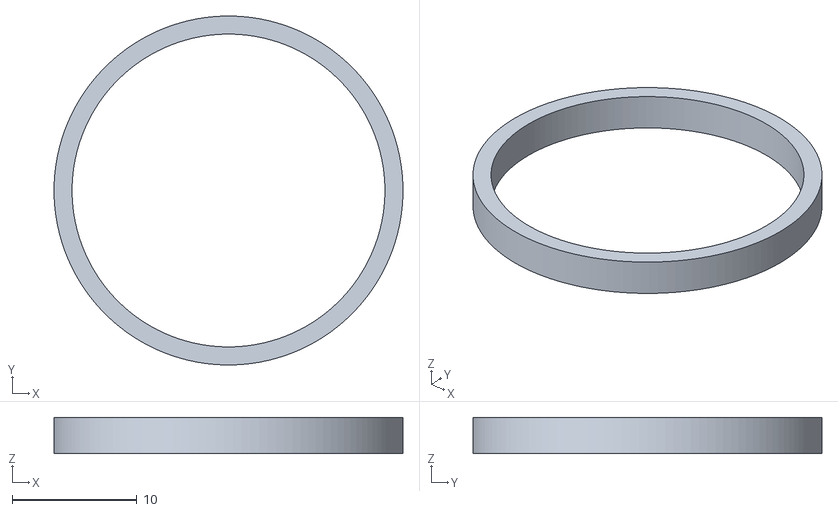
[picture p45: CAD file, 2026-10-08]
print/stl/act_bearing_spacer.stl
28.0 x 28.0 x 2.90
