JohnHurley16/RoboArm/sim/assets/meshes/fore_white.stl

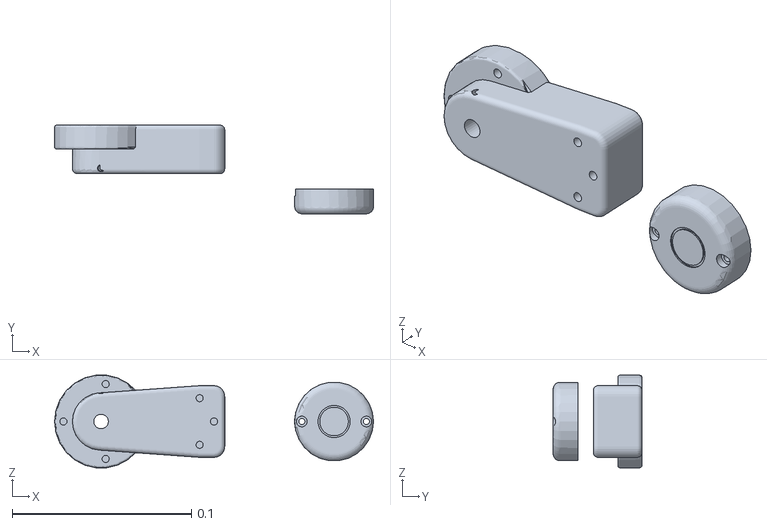
[picture p46: CAD file, 2026-10-08]
sim/assets/meshes/fore_white.stl
0.178 x 0.0495 x 0.0517
