JohnHurley16/RoboArm/print/plates/plate_14_s6_graphite.3mf

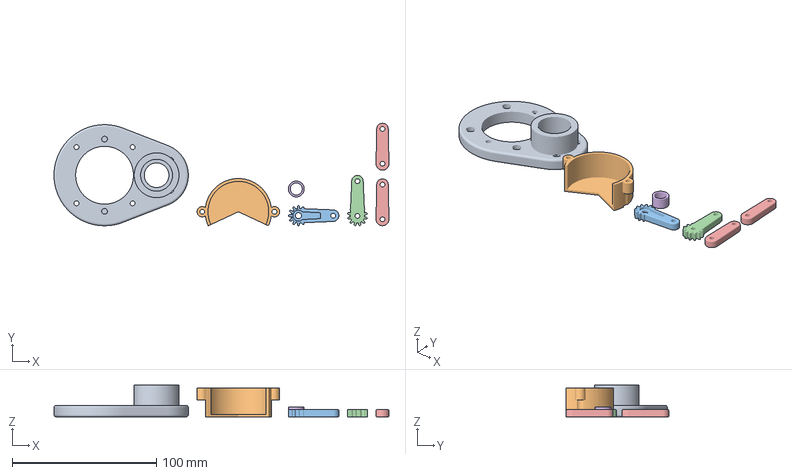
[picture p47: CAD file, 2026-10-08]
print/plates/plate_14_s6_graphite.3mf
231.9 x 71.0 x 22.0 mm
wrist_yoke
roll_pulley_guard
link_drive_upper
link_drive_lower
link_follow x 2
roll_spacer
