JohnHurley16/RoboArm/print/stl/finray_tpu.stl

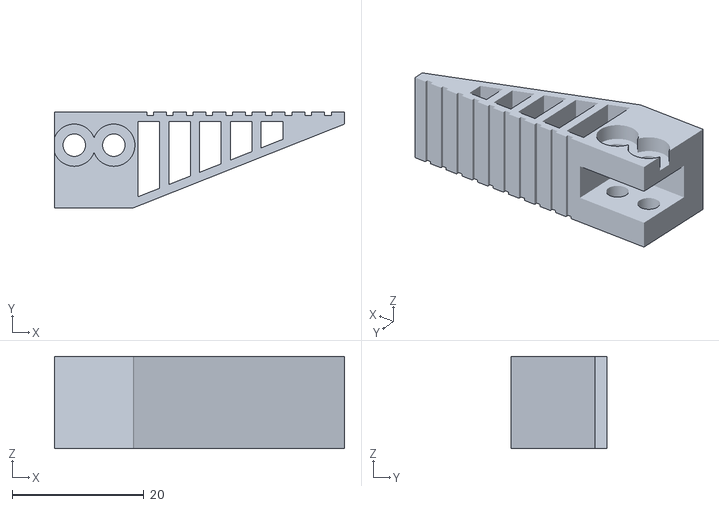
[picture p48: CAD file, 2026-10-08]
print/stl/finray_tpu.stl
44.0 x 14.5 x 14.0
