JohnHurley16/RoboArm/sim/assets/meshes/fore_black.stl

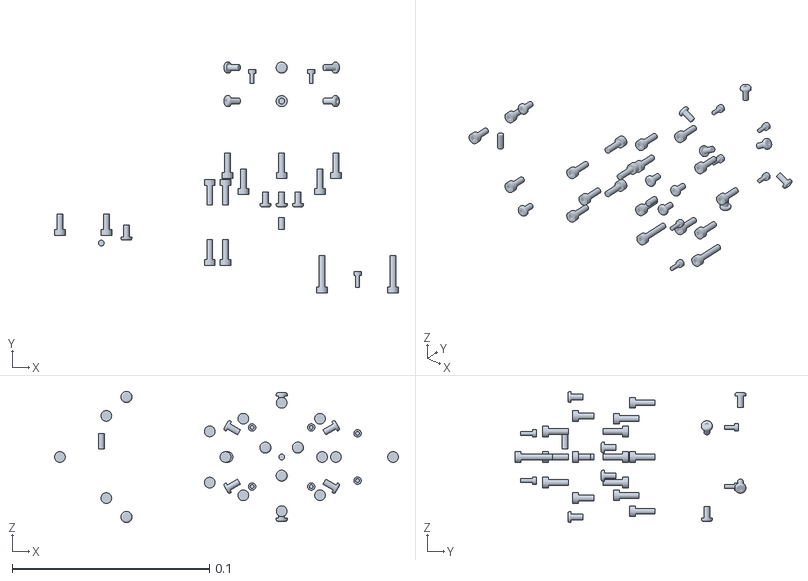
[picture p49: CAD file, 2026-10-08]
sim/assets/meshes/fore_black.stl
0.174 x 0.117 x 0.0665
