JohnHurley16/RoboArm/print/plates/plate_08_s3_white.3mf

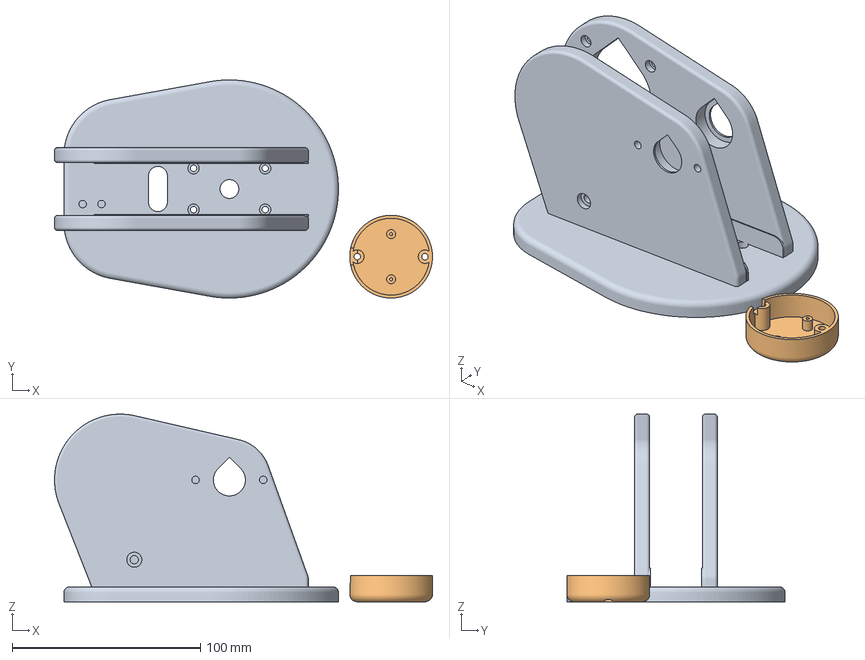
[picture p50: CAD file, 2026-10-08]
print/plates/plate_08_s3_white.3mf
201.0 x 116.0 x 99.8 mm
turret_body
joint_cap
