JohnHurley16/RoboArm/print/stl/forearm_cheek_b.stl

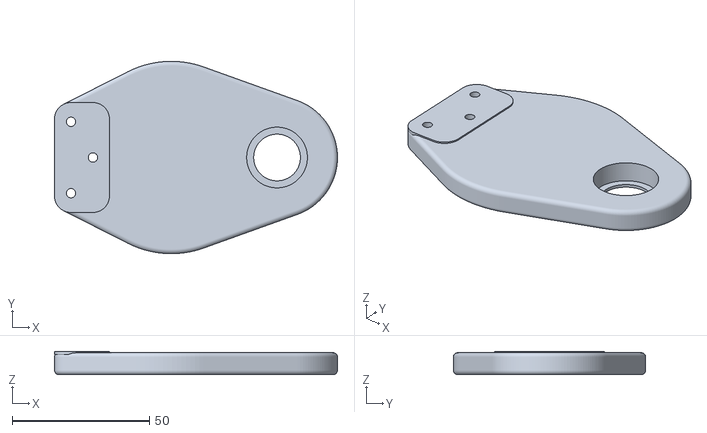
[picture p51: CAD file, 2026-10-08]
print/stl/forearm_cheek_b.stl
103.0 x 70.0 x 8.50
