JohnHurley16/RoboArm/sim/assets/meshes/grip_orange.stl

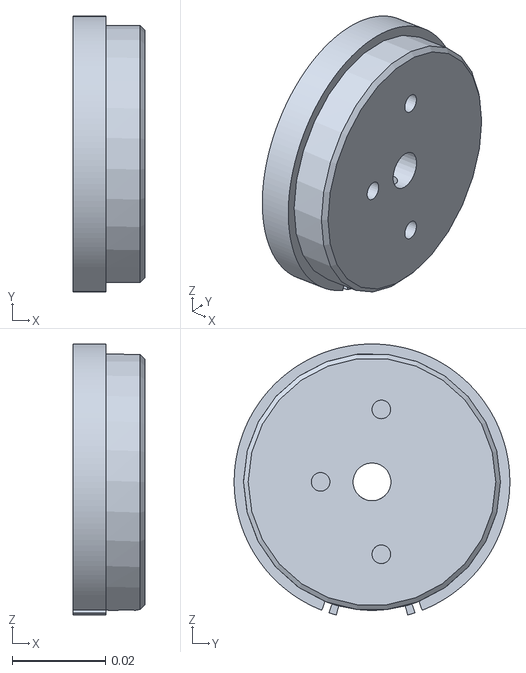
[picture p52: CAD file, 2026-10-08]
sim/assets/meshes/grip_orange.stl
0.0154 x 0.059 x 0.058
