JohnHurley16/RoboArm/print/plates/plate_02_s1_graphite.3mf

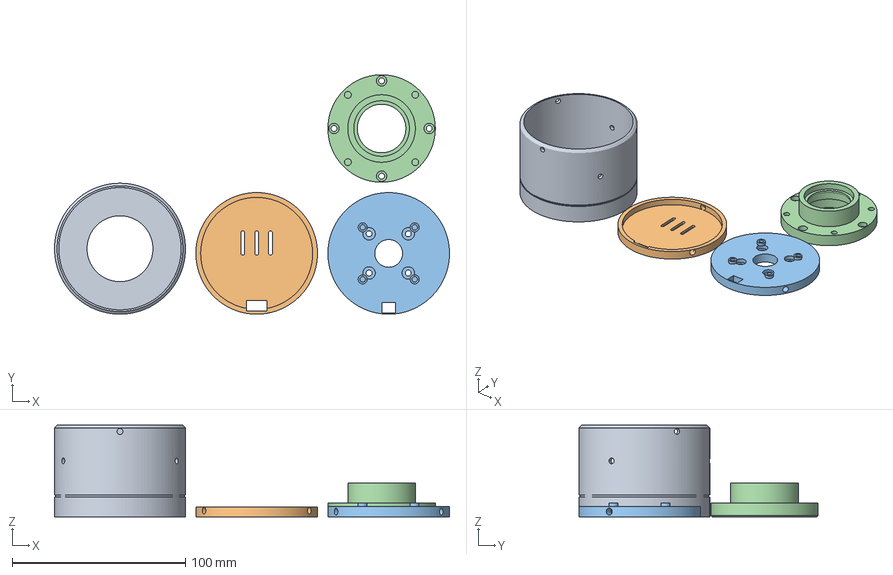
[picture p53: CAD file, 2026-10-08]
print/plates/plate_02_s1_graphite.3mf
228.0 x 138.2 x 52.9 mm
act_motor_can_GL60
act_rear_lid_GL60
act_rear_plate_GL60
act_front_cap
