JohnHurley16/RoboArm/print/stl/act_front_cap.stl

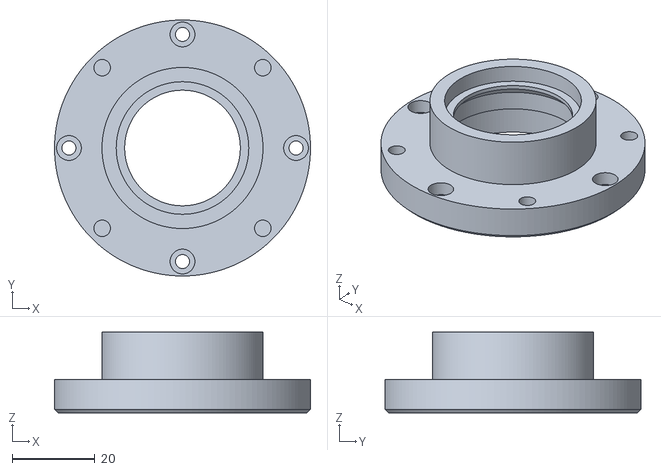
[picture p54: CAD file, 2026-10-08]
print/stl/act_front_cap.stl
62.0 x 62.0 x 19.5
