JohnHurley16/RoboArm/sim/assets/meshes/upper_black.stl

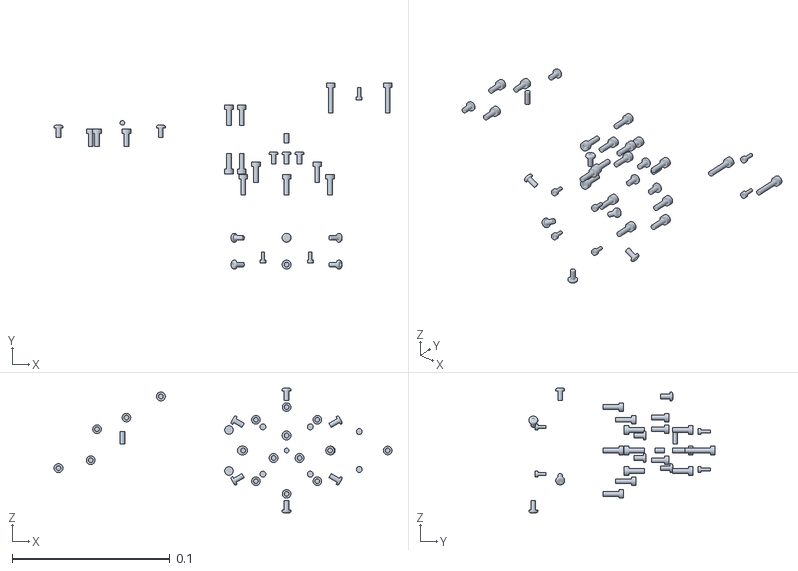
[picture p55: CAD file, 2026-10-08]
sim/assets/meshes/upper_black.stl
0.214 x 0.118 x 0.0789
