JohnHurley16/RoboArm/print/plates/plate_05_s2_graphite.3mf

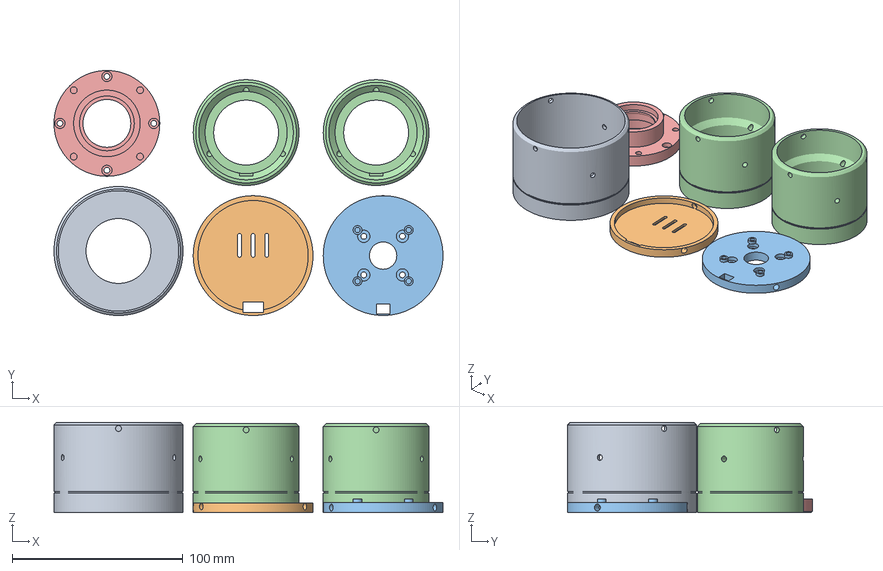
[picture p56: CAD file, 2026-10-08]
print/plates/plate_05_s2_graphite.3mf
228.0 x 143.6 x 52.9 mm
act_motor_can_GL60
act_rear_lid_GL60
act_rear_plate_GL60
act_motor_can_GL40 x 2
act_front_cap
