JohnHurley16/RoboArm/print/stl/palm.stl

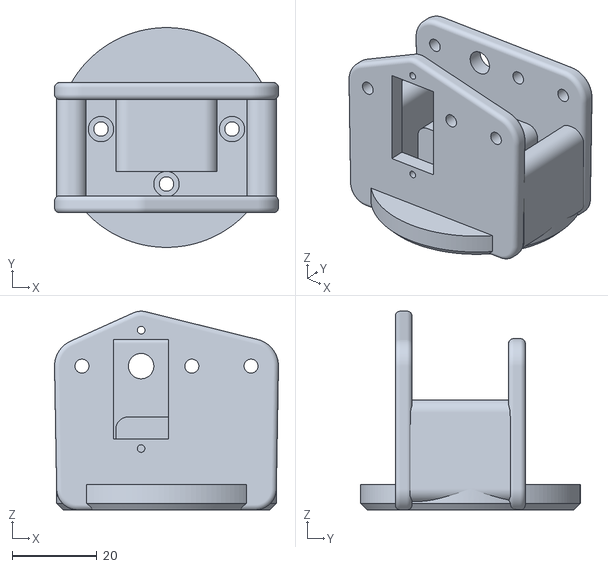
[picture p57: CAD file, 2026-10-08]
print/stl/palm.stl
53.0 x 52.0 x 47.0
