JohnHurley16/RoboArm/sim/assets/meshes/fu_black.stl

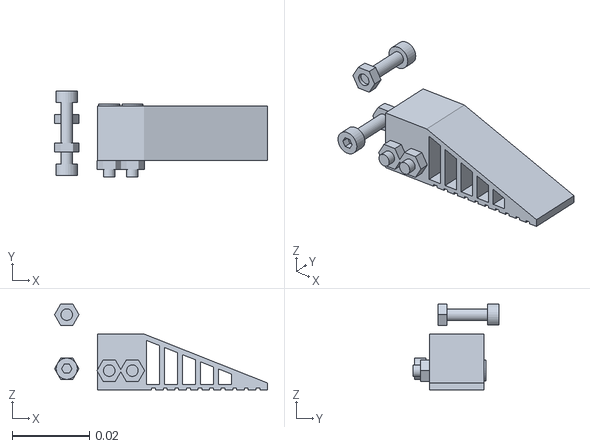
[picture p58: CAD file, 2026-10-08]
sim/assets/meshes/fu_black.stl
0.0552 x 0.0224 x 0.0223
