JohnHurley16/RoboArm/sim/assets/meshes/upper_white.stl

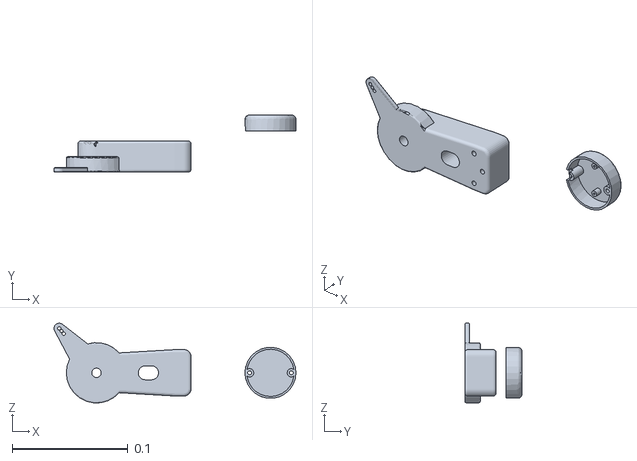
[picture p59: CAD file, 2026-10-08]
sim/assets/meshes/upper_white.stl
0.209 x 0.0495 x 0.0687
