JohnHurley16/RoboArm/print/stl/act_rear_lid_GL60.stl

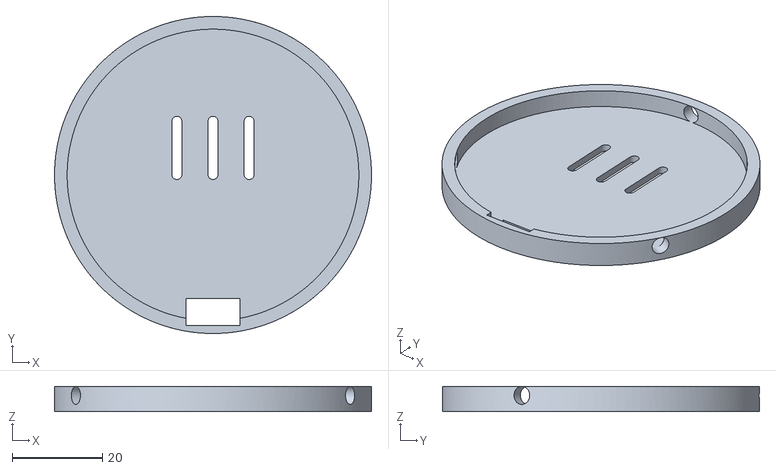
[picture p60: CAD file, 2026-10-08]
print/stl/act_rear_lid_GL60.stl
70.2 x 70.2 x 5.60
