JohnHurley16/RoboArm/sim/assets/meshes/turret_orange.stl

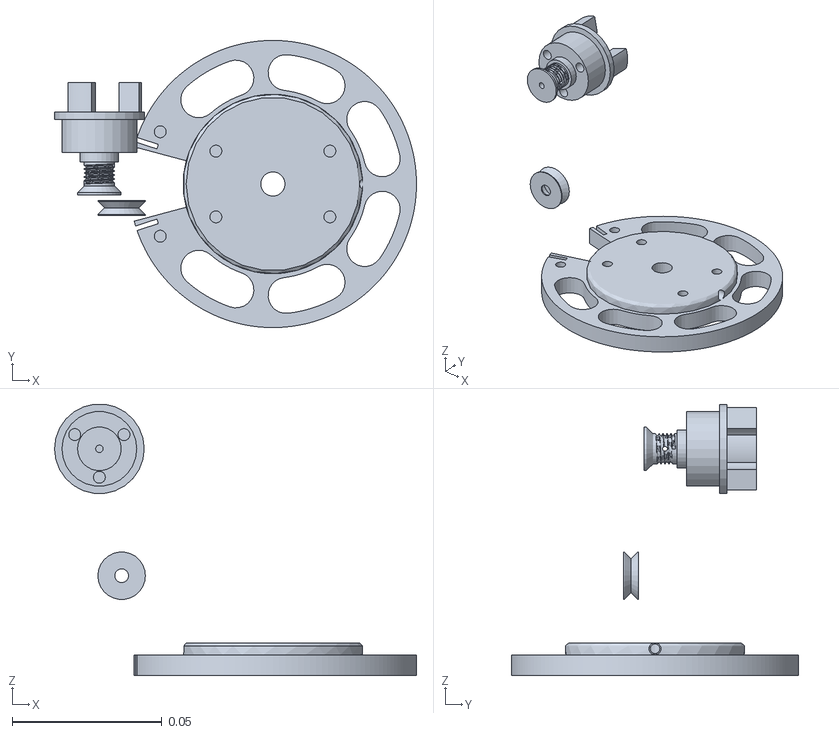
[picture p61: CAD file, 2026-10-08]
sim/assets/meshes/turret_orange.stl
0.121 x 0.096 x 0.0907
