JohnHurley16/RoboArm/print/stl/balancer_spacer.stl

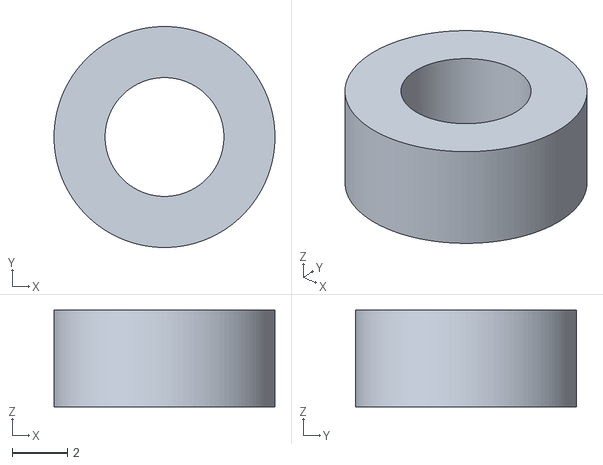
[picture p62: CAD file, 2026-10-08]
print/stl/balancer_spacer.stl
8.00 x 8.00 x 3.50
