JohnHurley16/RoboArm/sim/assets/meshes/grip_steel.stl

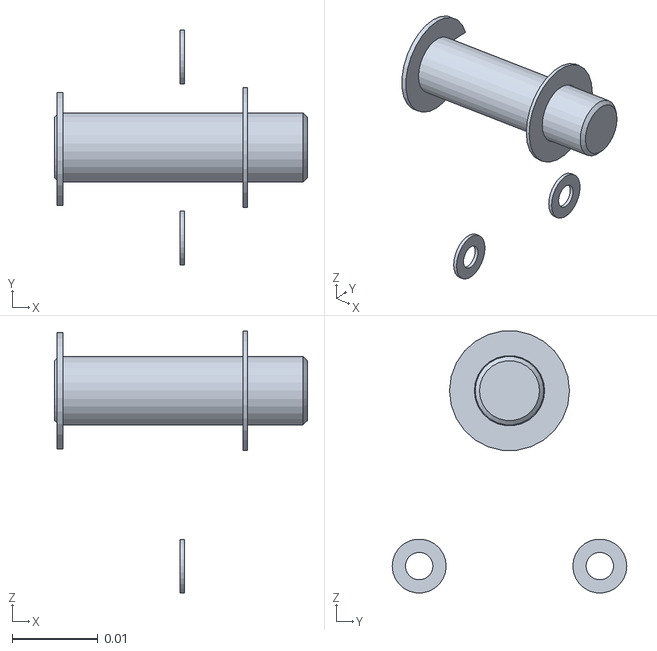
[picture p63: CAD file, 2026-10-08]
sim/assets/meshes/grip_steel.stl
0.0295 x 0.0274 x 0.0305
