JohnHurley16/RoboArm/print/stl/act_rear_plate_GL40.stl

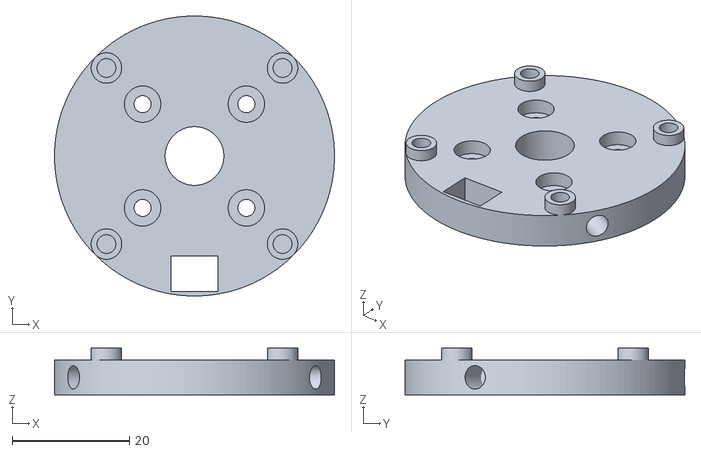
[picture p64: CAD file, 2026-10-08]
print/stl/act_rear_plate_GL40.stl
47.7 x 47.7 x 8.00
