JohnHurley16/RoboArm/sim/assets/meshes/upper_graphite.stl

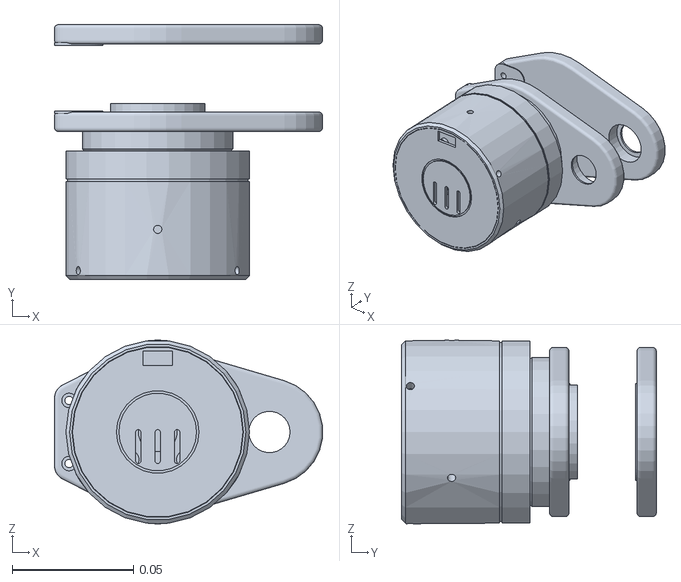
[picture p65: CAD file, 2026-10-08]
sim/assets/meshes/upper_graphite.stl
0.11 x 0.105 x 0.0756
