JohnHurley16/RoboArm/print/stl/roll_spacer.stl

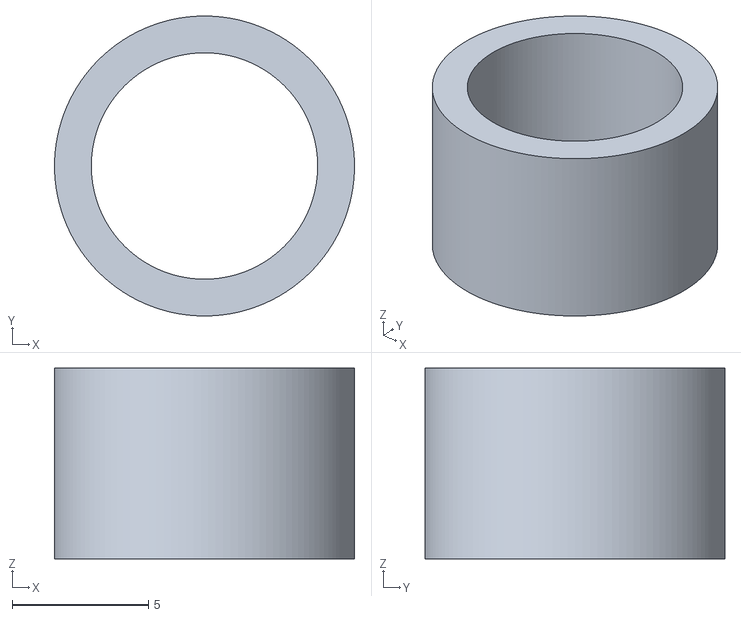
[picture p66: CAD file, 2026-10-08]
print/stl/roll_spacer.stl
11.0 x 11.0 x 7.00
