JohnHurley16/RoboArm/sim/assets/meshes/base_graphite.stl

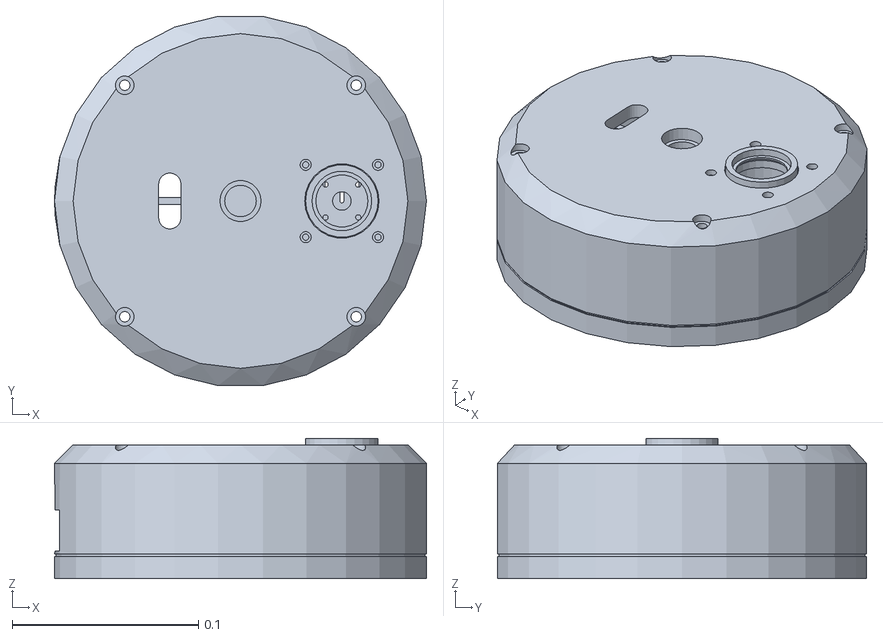
[picture p67: CAD file, 2026-10-08]
sim/assets/meshes/base_graphite.stl
0.2 x 0.199 x 0.0755
