JohnHurley16/RoboArm/print/stl/balancer_tube.stl

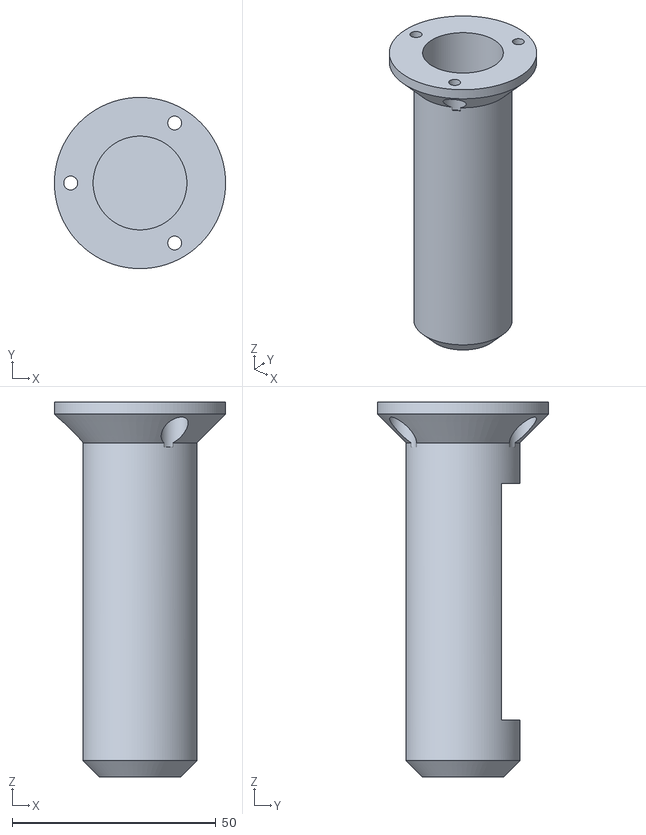
[picture p68: CAD file, 2026-10-08]
print/stl/balancer_tube.stl
42.0 x 42.0 x 92.0
