JohnHurley16/RoboArm/sim/assets/meshes/hand_graphite.stl

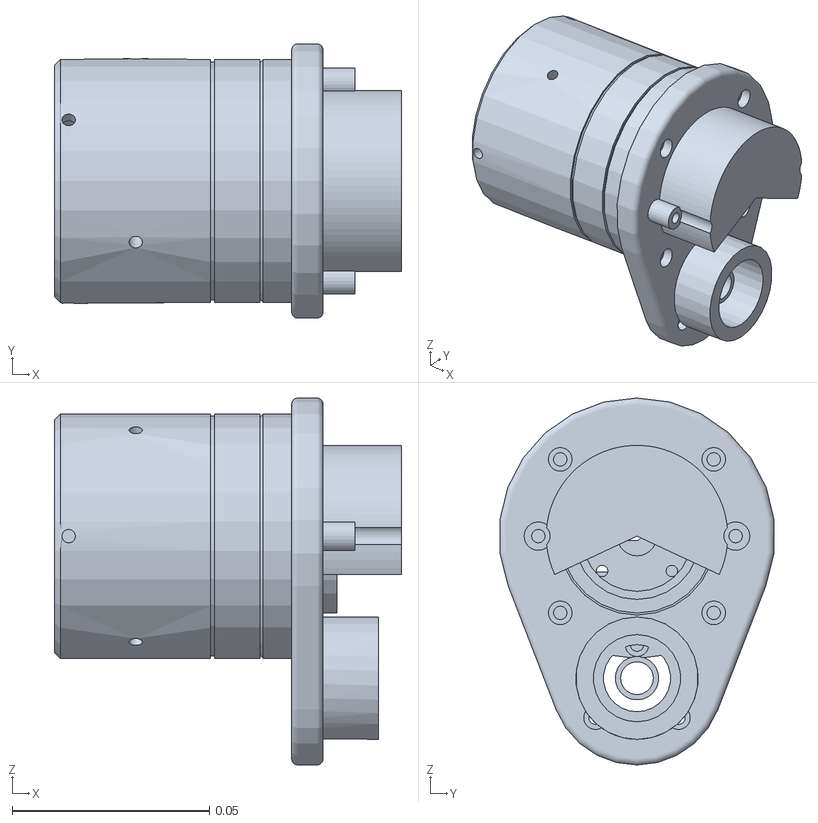
[picture p69: CAD file, 2026-10-08]
sim/assets/meshes/hand_graphite.stl
0.088 x 0.0695 x 0.093
