JohnHurley16/RoboArm/print/stl/forearm_cheek_a.stl

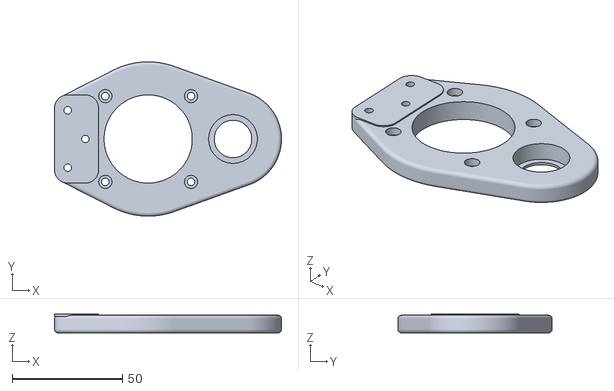
[picture p70: CAD file, 2026-10-08]
print/stl/forearm_cheek_a.stl
103.0 x 70.0 x 8.50
