JohnHurley16/RoboArm/sim/assets/meshes/l2l_graphite.stl

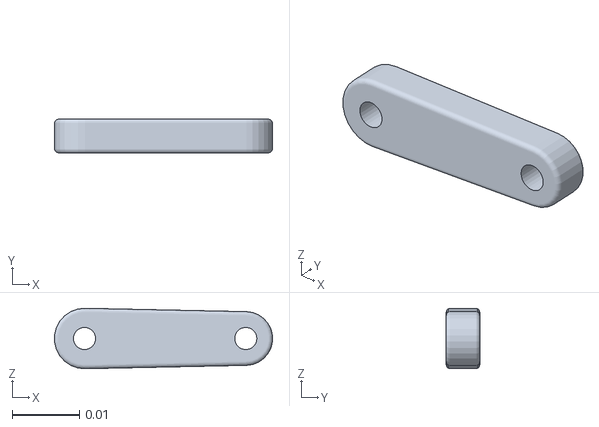
[picture p71: CAD file, 2026-10-08]
sim/assets/meshes/l2l_graphite.stl
0.0324 x 0.005 x 0.009
