JohnHurley16/RoboArm/print/stl/act_rear_plate_GL60.stl

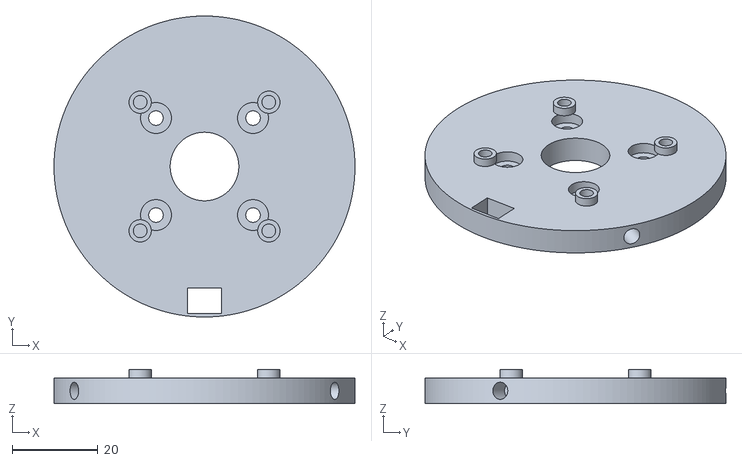
[picture p72: CAD file, 2026-10-08]
print/stl/act_rear_plate_GL60.stl
70.2 x 70.2 x 8.00
