JohnHurley16/RoboArm/print/stl/act_rotor_adapter_GL60.stl

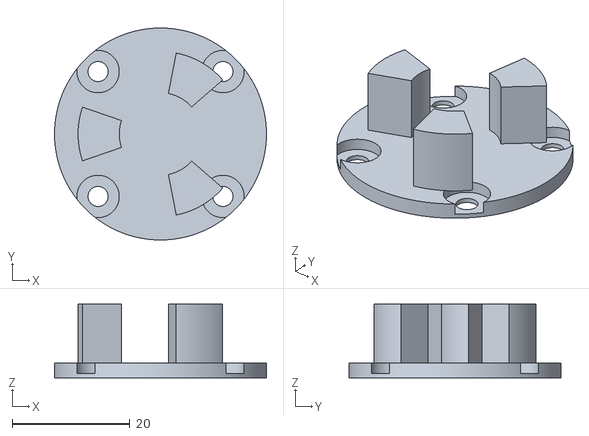
[picture p73: CAD file, 2026-10-08]
print/stl/act_rotor_adapter_GL60.stl
36.0 x 36.0 x 12.5
