JohnHurley16/RoboArm/sim/assets/meshes/base_orange.stl

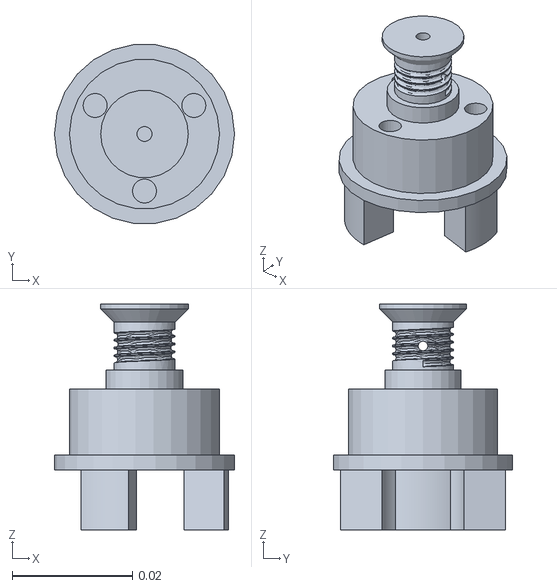
[picture p74: CAD file, 2026-10-08]
sim/assets/meshes/base_orange.stl
0.03 x 0.0298 x 0.0376
