JohnHurley16/RoboArm/print/stl/hand.stl

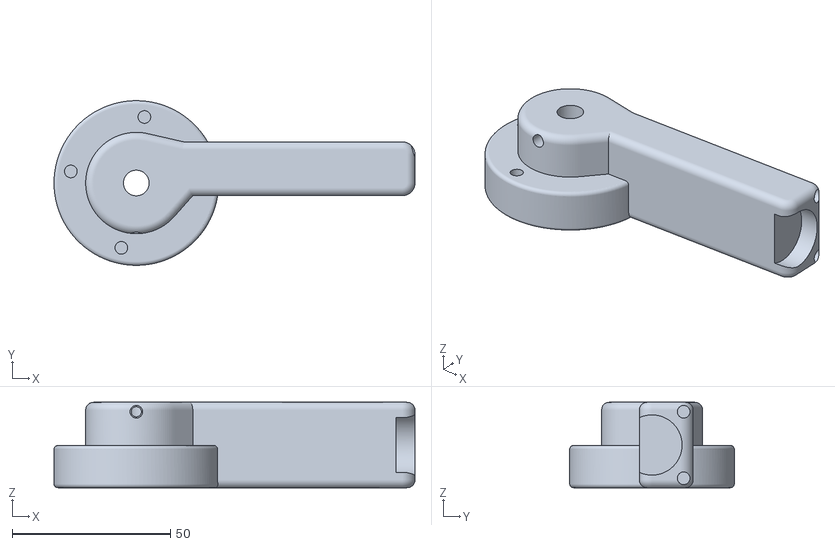
[picture p75: CAD file, 2026-10-08]
print/stl/hand.stl
114.0 x 52.0 x 27.0
