JohnHurley16/RoboArm/sim/assets/meshes/turret_black.stl

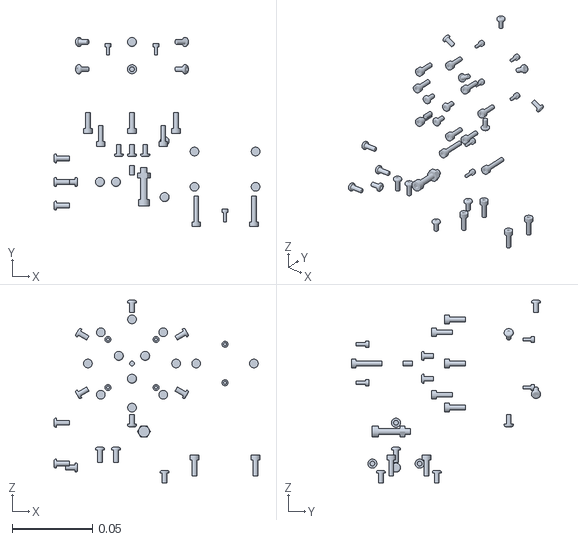
[picture p76: CAD file, 2026-10-08]
sim/assets/meshes/turret_black.stl
0.128 x 0.118 x 0.114
