JohnHurley16/RoboArm/print/stl/act_retainer_ring.stl

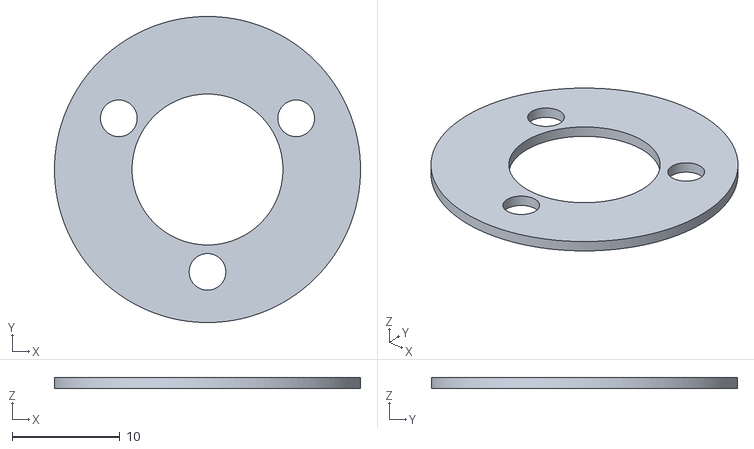
[picture p77: CAD file, 2026-10-08]
print/stl/act_retainer_ring.stl
28.4 x 28.4 x 1.00
