JohnHurley16/RoboArm/sim/assets/meshes/upper_steel.stl

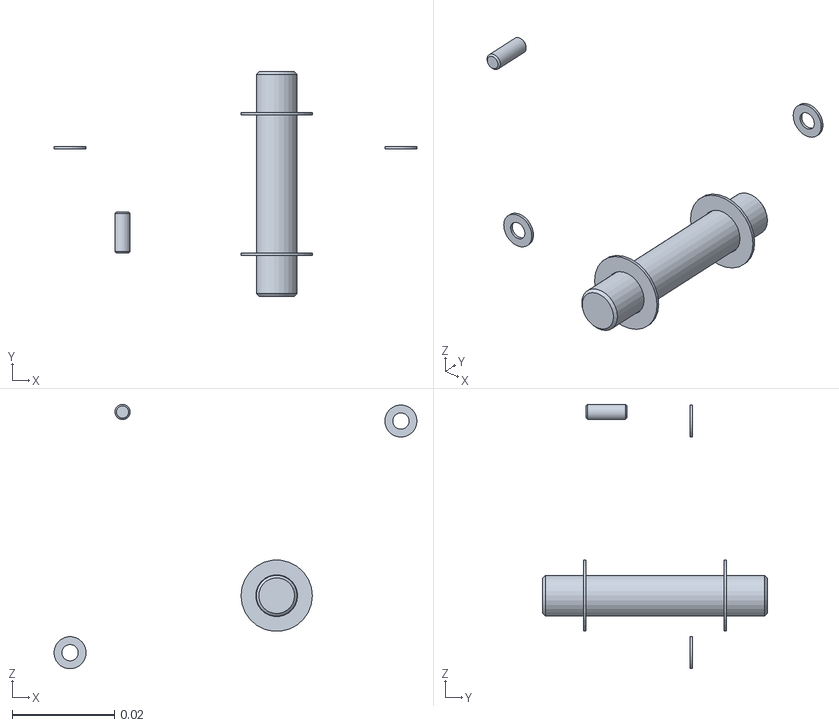
[picture p78: CAD file, 2026-10-08]
sim/assets/meshes/upper_steel.stl
0.0711 x 0.044 x 0.0518
