JohnHurley16/RoboArm/print/stl/servo_cover.stl

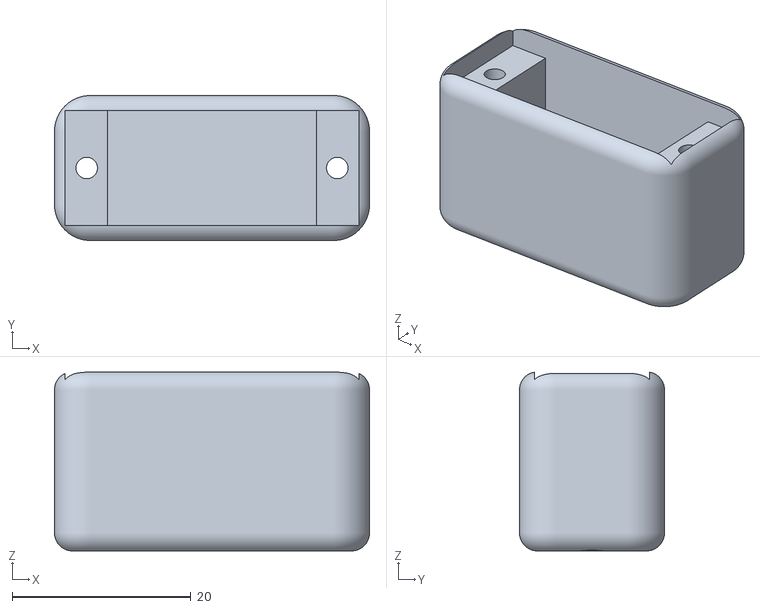
[picture p79: CAD file, 2026-10-08]
print/stl/servo_cover.stl
35.2 x 16.2 x 20.0
