JohnHurley16/RoboArm/sim/assets/meshes/fore_orange.stl

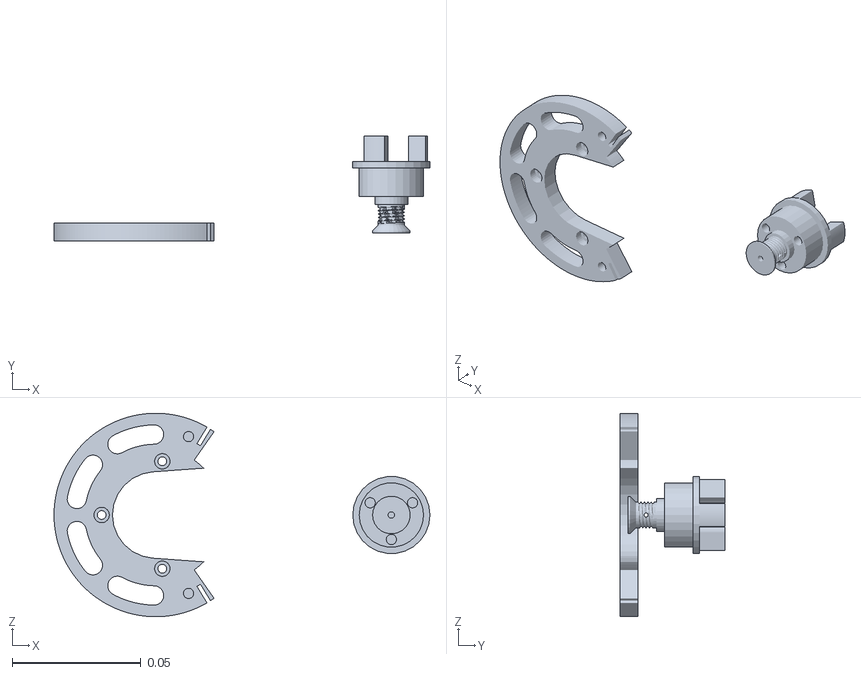
[picture p80: CAD file, 2026-10-08]
sim/assets/meshes/fore_orange.stl
0.146 x 0.0409 x 0.079
