JohnHurley16/RoboArm/print/stl/balancer_idler.stl

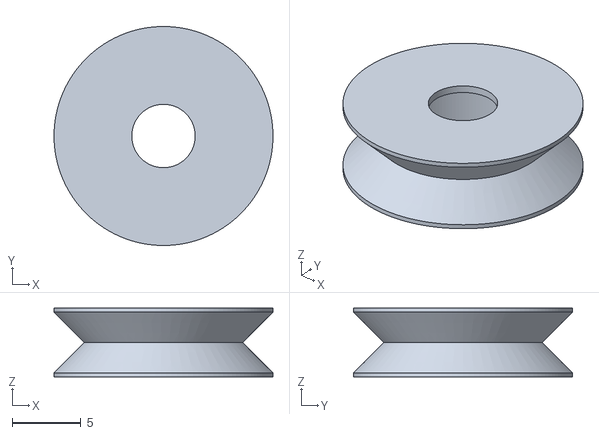
[picture p81: CAD file, 2026-10-08]
print/stl/balancer_idler.stl
15.9 x 15.9 x 5.00
