JohnHurley16/RoboArm/print/stl/balancer_bracket.stl

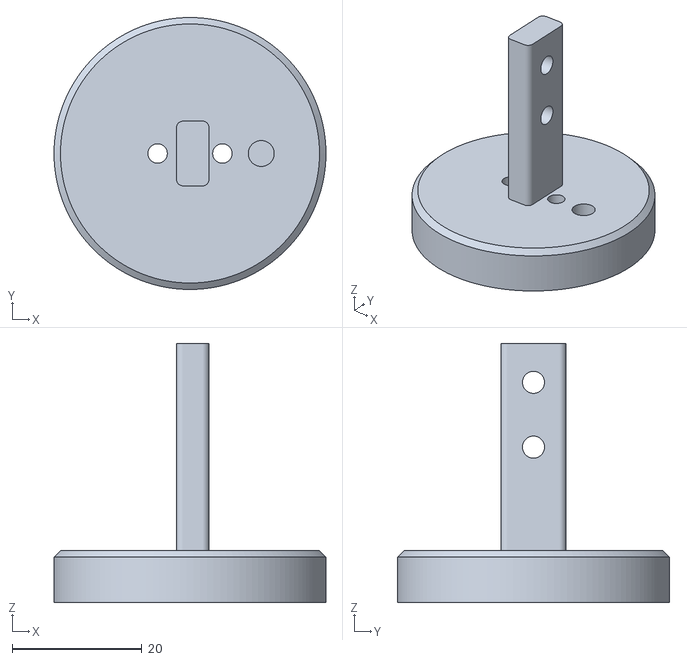
[picture p82: CAD file, 2026-10-08]
print/stl/balancer_bracket.stl
42.0 x 42.0 x 40.0
