JohnHurley16/RoboArm/sim/assets/meshes/turret_graphite.stl

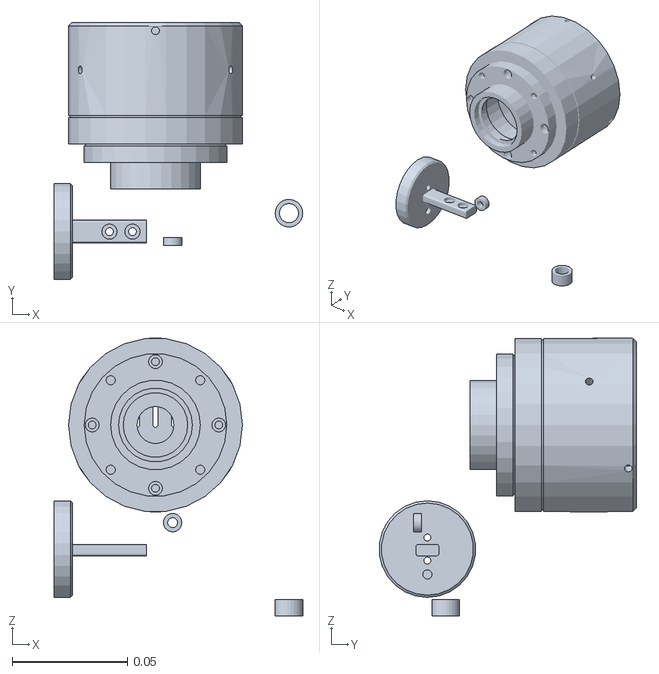
[picture p83: CAD file, 2026-10-08]
sim/assets/meshes/turret_graphite.stl
0.108 x 0.112 x 0.121
