JohnHurley16/RoboArm/print/stl/finger.stl

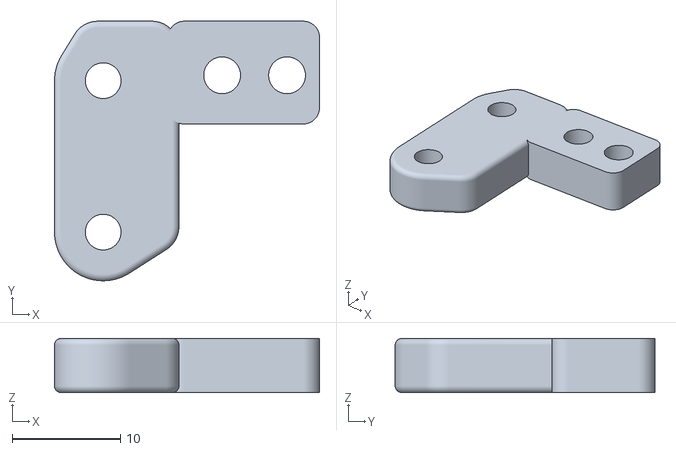
[picture p84: CAD file, 2026-10-08]
print/stl/finger.stl
24.5 x 24.0 x 5.00
