JohnHurley16/RoboArm/print/stl/turret_drum.stl

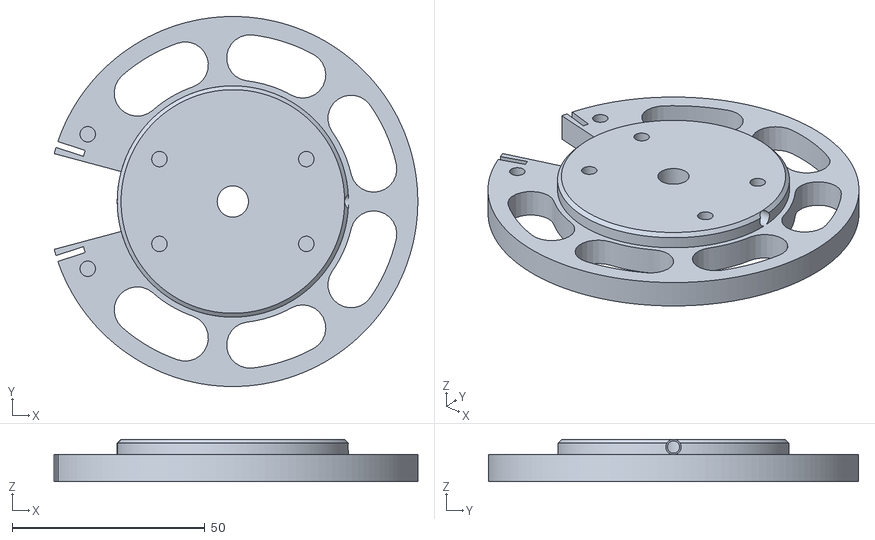
[picture p85: CAD file, 2026-10-08]
print/stl/turret_drum.stl
94.4 x 96.0 x 11.0
