JohnHurley16/RoboArm/sim/assets/meshes/fore_steel.stl

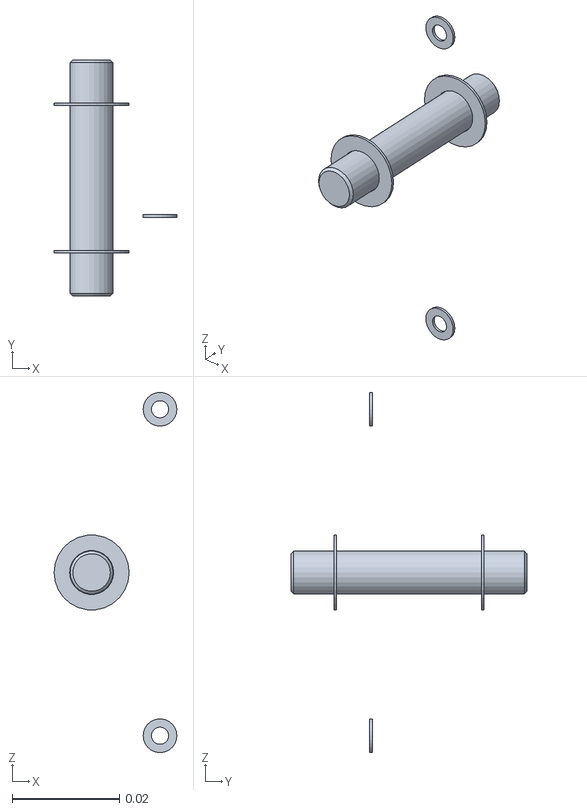
[picture p86: CAD file, 2026-10-08]
sim/assets/meshes/fore_steel.stl
0.0229 x 0.044 x 0.0671
