JohnHurley16/RoboArm/print/stl/balancer_piston.stl

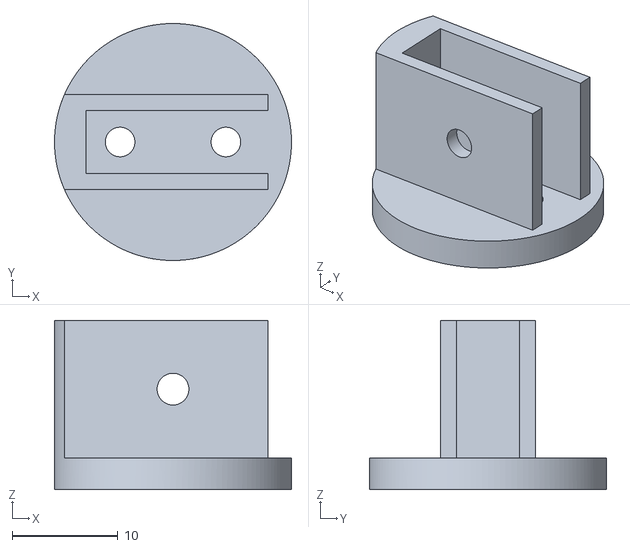
[picture p87: CAD file, 2026-10-08]
print/stl/balancer_piston.stl
22.4 x 22.4 x 16.0
