JohnHurley16/RoboArm/sim/assets/meshes/hand_black.stl

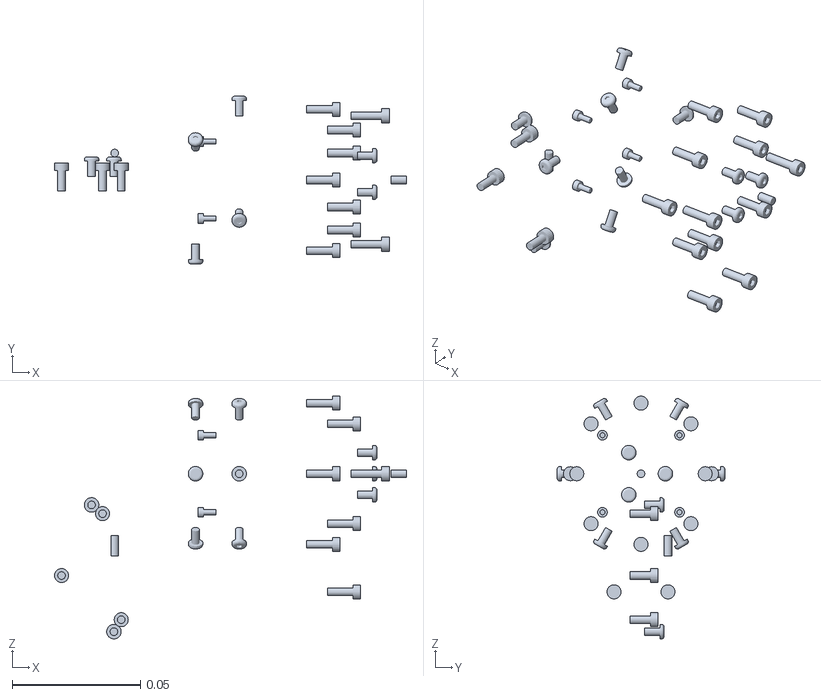
[picture p88: CAD file, 2026-10-08]
sim/assets/meshes/hand_black.stl
0.137 x 0.0653 x 0.0946
