JohnHurley16/RoboArm/print/stl/link_follow.stl

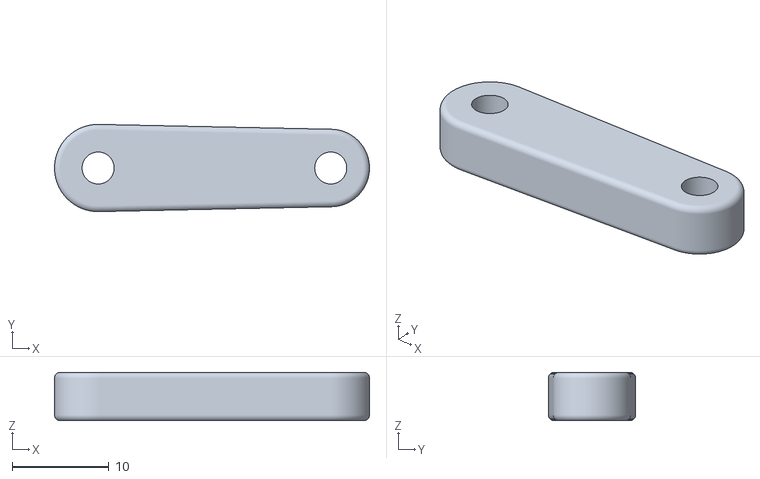
[picture p89: CAD file, 2026-10-08]
print/stl/link_follow.stl
32.5 x 9.00 x 5.00
