JohnHurley16/RoboArm/sim/assets/meshes/grip_black.stl

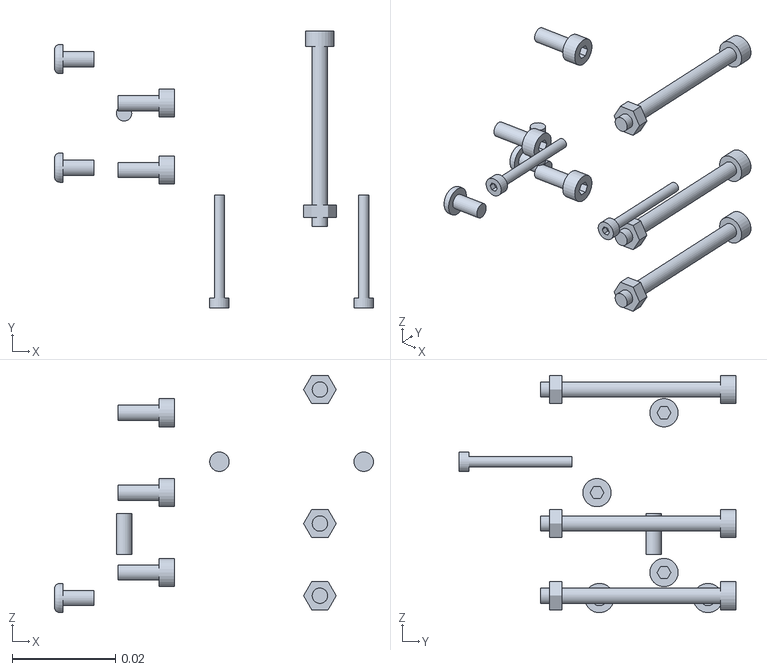
[picture p90: CAD file, 2026-10-08]
sim/assets/meshes/grip_black.stl
0.0619 x 0.0538 x 0.046
