JohnHurley16/RoboArm/print/stl/j1_spacer.stl

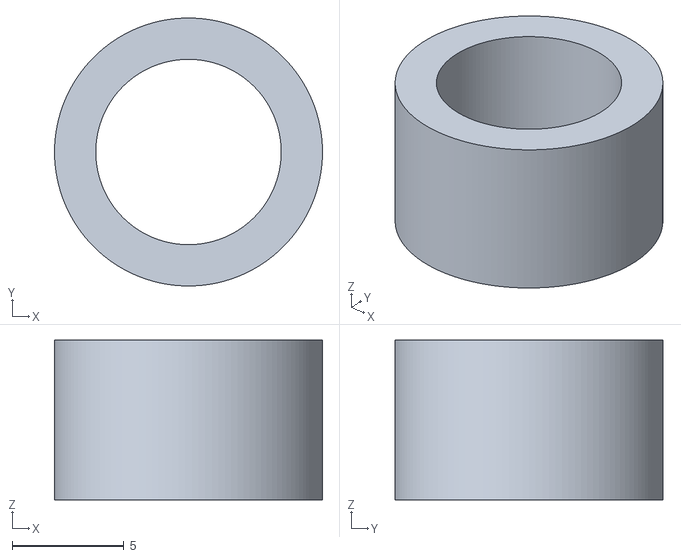
[picture p91: CAD file, 2026-10-08]
print/stl/j1_spacer.stl
12.0 x 12.0 x 7.15
