JohnHurley16/RoboArm/sim/assets/meshes/turret_white.stl

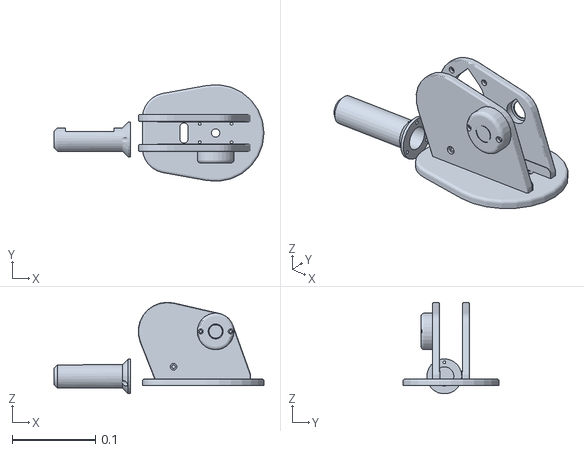
[picture p92: CAD file, 2026-10-08]
sim/assets/meshes/turret_white.stl
0.252 x 0.116 x 0.11
