JohnHurley16/RoboArm/print/stl/act_rear_lid_GL40.stl

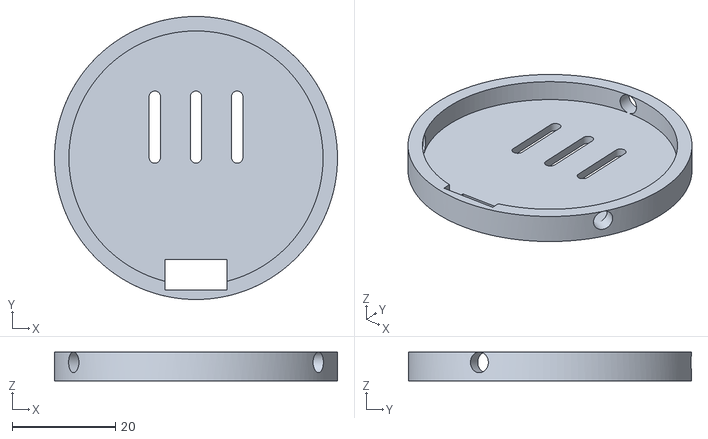
[picture p93: CAD file, 2026-10-08]
print/stl/act_rear_lid_GL40.stl
54.9 x 54.9 x 5.60
