JohnHurley16/RoboArm/print/stl/sector_j2.stl

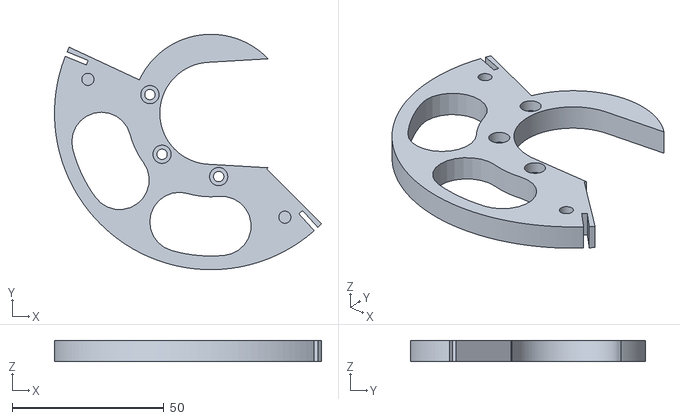
[picture p94: CAD file, 2026-10-08]
print/stl/sector_j2.stl
87.9 x 77.5 x 7.00
