JohnHurley16/RoboArm/sim/assets/meshes/grip_white.stl

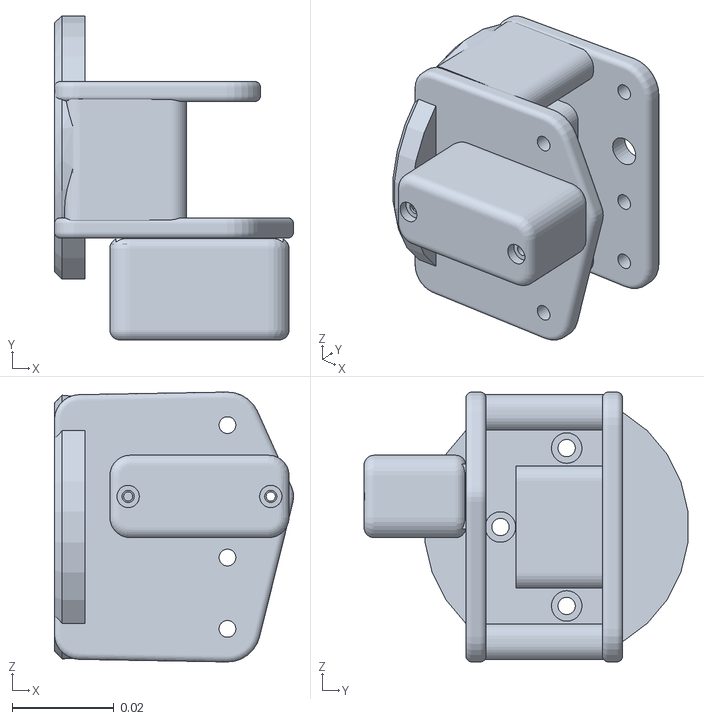
[picture p95: CAD file, 2026-10-08]
sim/assets/meshes/grip_white.stl
0.047 x 0.0636 x 0.053
