JohnHurley16/RoboArm/print/stl/act_hub.stl

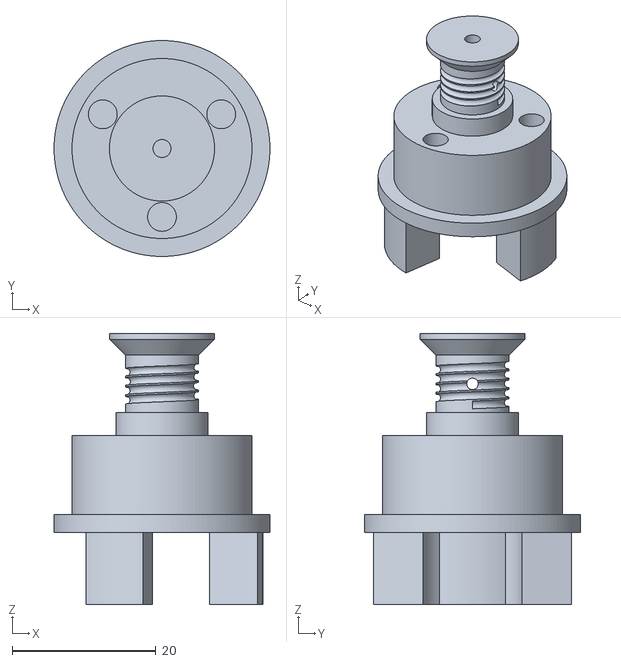
[picture p96: CAD file, 2026-10-08]
print/stl/act_hub.stl
30.0 x 30.0 x 37.7
