JohnHurley16/RoboArm/sim/assets/meshes/upper_orange.stl

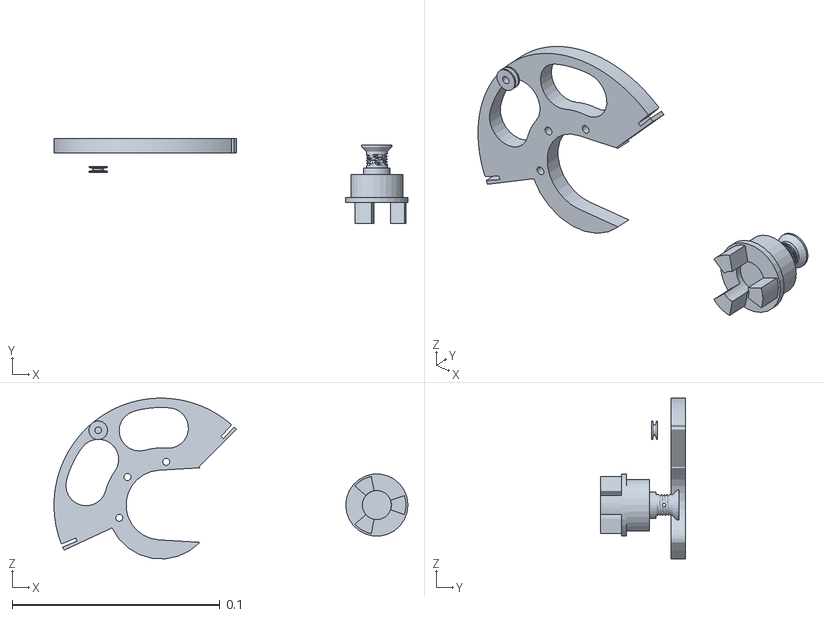
[picture p97: CAD file, 2026-10-08]
sim/assets/meshes/upper_orange.stl
0.171 x 0.0409 x 0.0774
