JohnHurley16/RoboArm/print/stl/joint_cap.stl

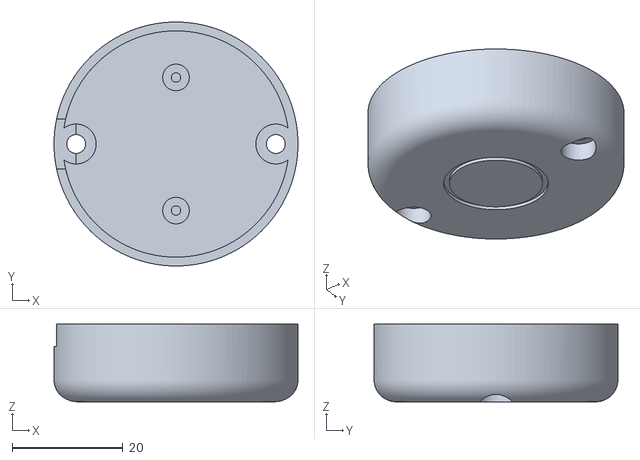
[picture p98: CAD file, 2026-10-08]
print/stl/joint_cap.stl
44.0 x 44.0 x 14.0
