JohnHurley16/RoboArm/print/stl/act_motor_can_GL40.stl

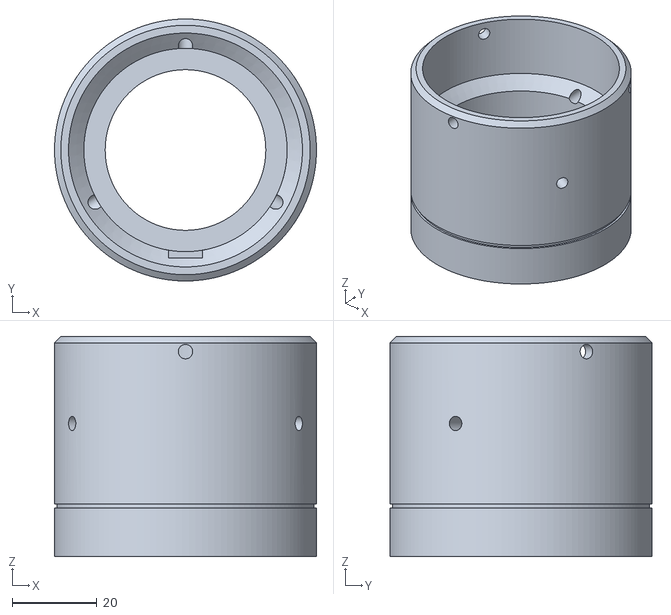
[picture p99: CAD file, 2026-10-08]
print/stl/act_motor_can_GL40.stl
62.0 x 62.0 x 52.1
