JohnHurley16/RoboArm/print/stl/upper_arm.stl

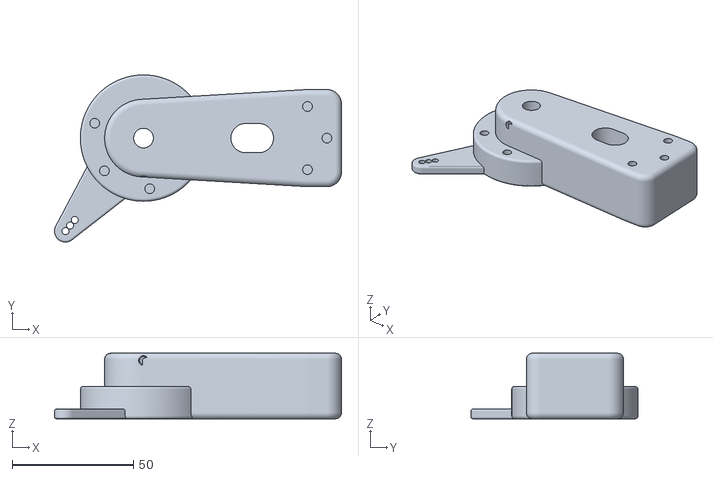
[picture p100: CAD file, 2026-10-08]
print/stl/upper_arm.stl
118.1 x 68.8 x 27.0
