JohnHurley16/RoboArm/print/stl/sector_j4.stl

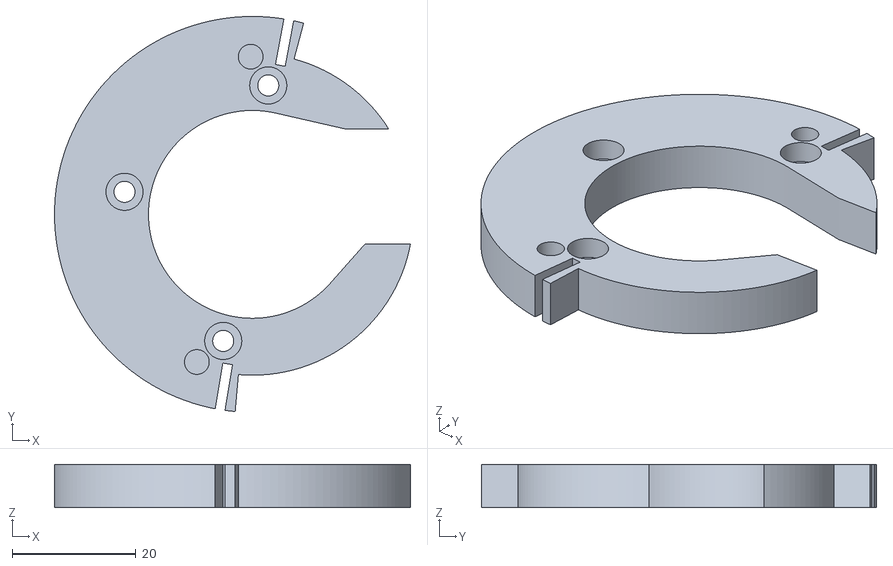
[picture p101: CAD file, 2026-10-08]
print/stl/sector_j4.stl
57.6 x 63.9 x 7.00
