JohnHurley16/RoboArm/print/stl/act_rotor_adapter_GL40.stl

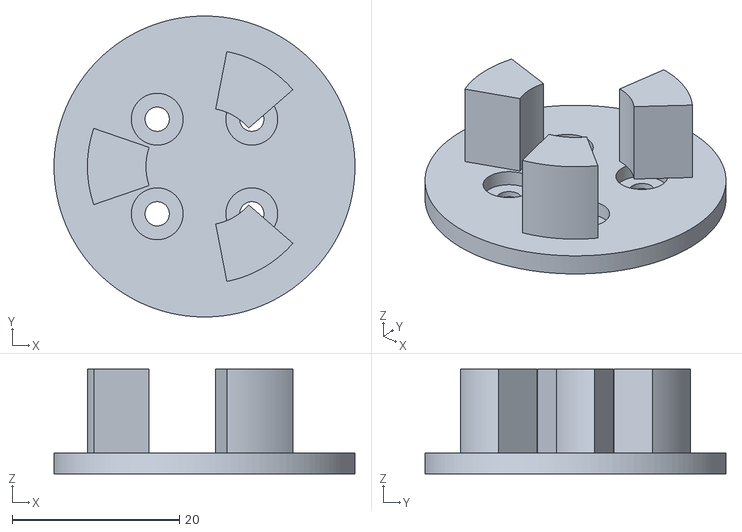
[picture p102: CAD file, 2026-10-08]
print/stl/act_rotor_adapter_GL40.stl
36.0 x 36.0 x 12.5
