JohnHurley16/RoboArm/print/stl/upper_arm_cheek_a.stl

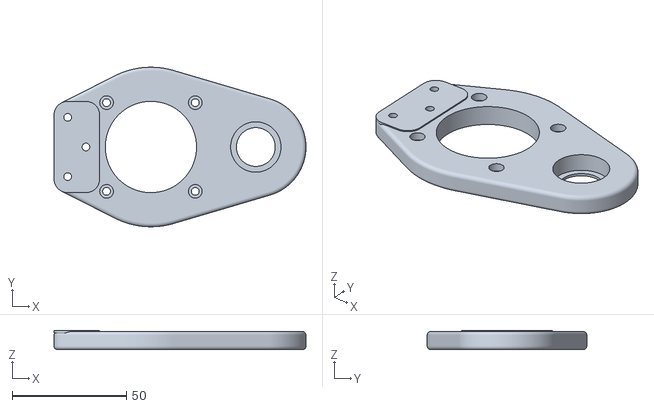
[picture p103: CAD file, 2026-10-08]
print/stl/upper_arm_cheek_a.stl
110.5 x 70.0 x 8.50
