JohnHurley16/RoboArm/print/stl/act_magnet_plug_GL60.stl

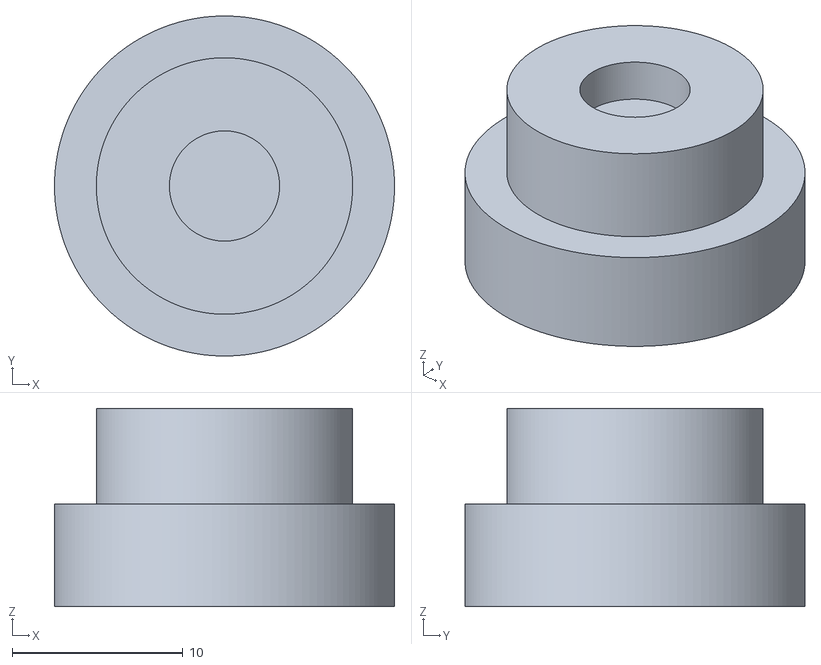
[picture p104: CAD file, 2026-10-08]
print/stl/act_magnet_plug_GL60.stl
19.9 x 19.9 x 11.6
