JohnHurley16/RoboArm/print/stl/turret_body.stl

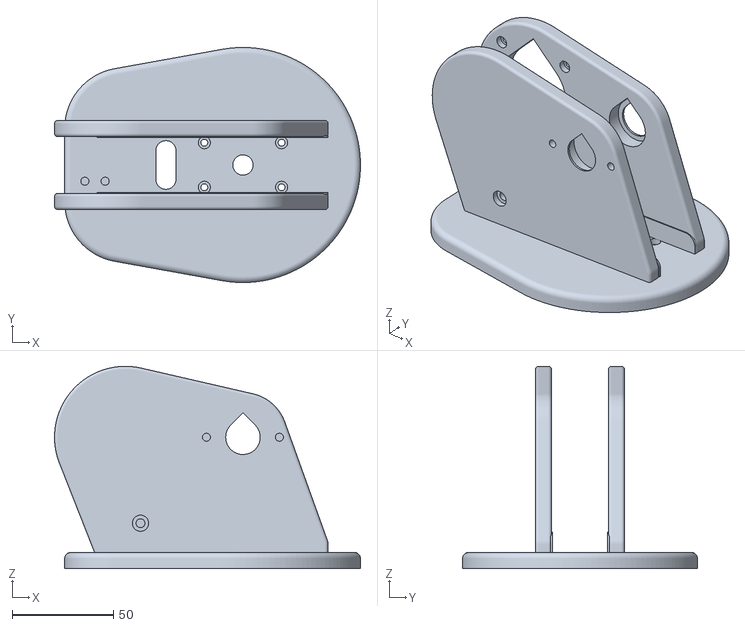
[picture p105: CAD file, 2026-10-08]
print/stl/turret_body.stl
151.0 x 116.0 x 99.8
