JohnHurley16/RoboArm/print/stl/balancer_piston_pulley.stl

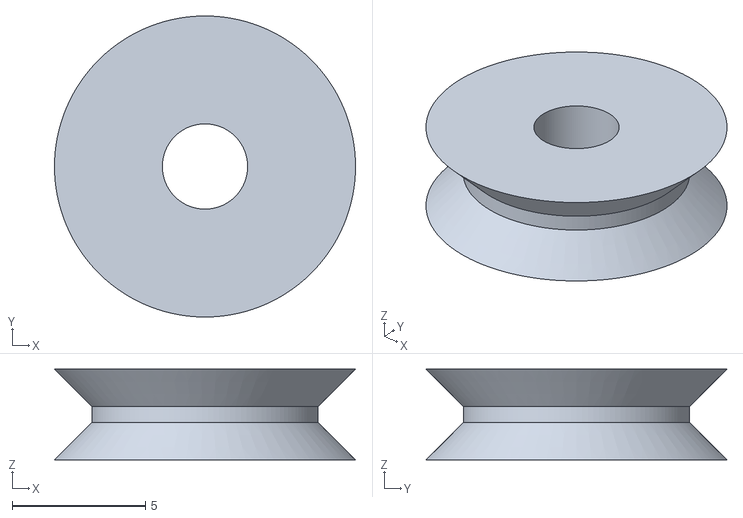
[picture p106: CAD file, 2026-10-08]
print/stl/balancer_piston_pulley.stl
11.3 x 11.3 x 3.40
