JohnHurley16/RoboArm/print/stl/act_spider_tpu.stl

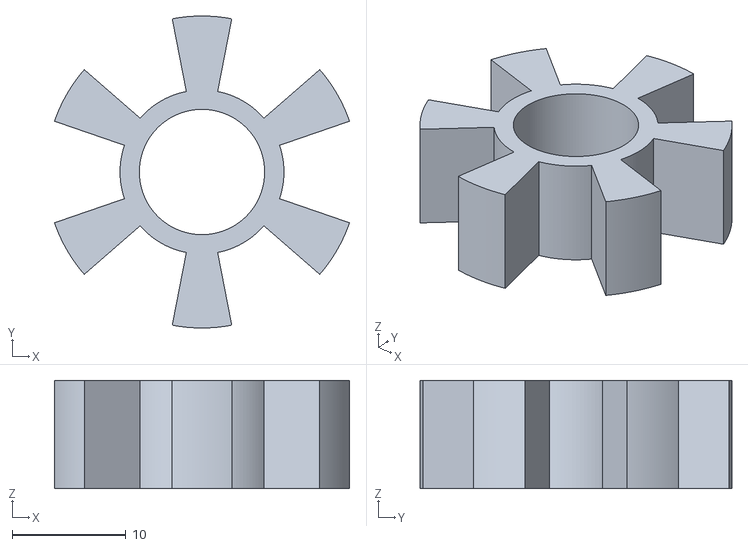
[picture p107: CAD file, 2026-10-08]
print/stl/act_spider_tpu.stl
25.9 x 27.4 x 9.50
