JohnHurley16/RoboArm/print/stl/sector_j3.stl

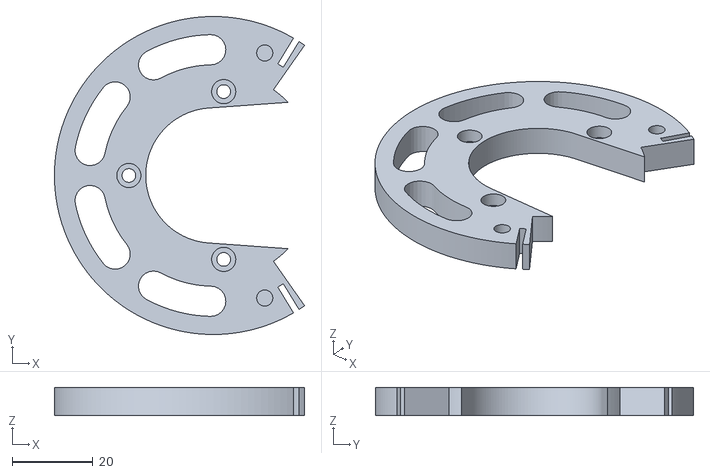
[picture p108: CAD file, 2026-10-08]
print/stl/sector_j3.stl
62.2 x 79.0 x 7.00
