JohnHurley16/RoboArm/(list of files, cad)

Other CAD files:
print/stl/base.stl
sim/assets/meshes/l1l_graphite.stl
sim/assets/meshes/fl_black.stl
print/stl/link_drive_upper.stl
