JohnHurley16/RoboArm/print/mini/mini_assembled_back.png

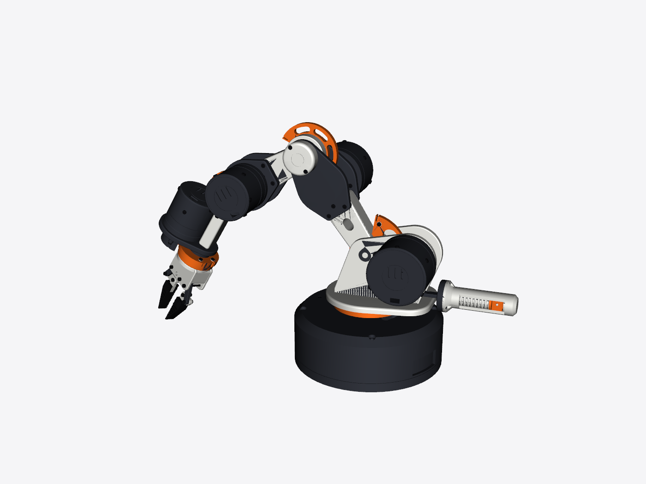
print/mini/mini_assembled_back.png
