JohnHurley16/RoboArm/print/mini/mini_plate.png

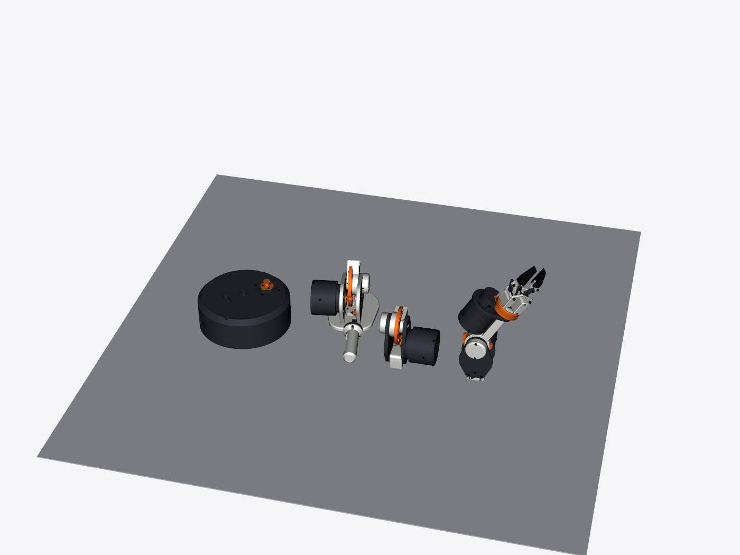
print/mini/mini_plate.png
