JohnHurley16/RoboArm/(commit log)

2026-10-08 Add parametric CAD, analyses and checks
    CadQuery model of the whole arm (cad/arm, every dimension in params.py),
    build.py to regenerate STL/STEP/BOM/report/viewer data, torque, balancer and
    accuracy analyses, collision and range-of-motion checks, print-plate and
    desk-model generators. legacy/ keeps the first drone-motor + cycloid design.
    Claude-Session: https://claude.ai/code/session_0129h27G85mKASAbnELCh65q
2026-10-08 Add print-ready files
    STLs in print orientation, Bambu P1S plates in assembly order, the 3 in
    multi-colour desk model, and STEP files of the assembly and actuators.
    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
    [act_bearing_spacer.stl, act_front_cap.stl, act_hub.stl, act_magnet_plug_GL40.stl, act_magnet_plug_GL60.stl, act_motor_can_GL40.stl, act_motor_can_GL60.stl, act_rear_lid_GL40.stl]
2026-10-08 Add design guide, priced BOM and 3D viewer
    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
    [BOM.csv, bom_priced.csv]
2026-10-08 Add closed-form inverse kinematics
    Tool pose (x, y, z, pitch, roll, grip) to joint angles and moteus positions,
    checked against the CAD; Jacobian, straight-line moves, moteus drive example.
    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
2026-10-08 Add MuJoCo/MJX simulator and RL training
    Arm model generated from the CAD with motor torque-speed curves, capstan
    ratios, moteus PD and gravity feedforward; floppy beanbag, pinch grip and
    table pickup; reach/lift/place/throw/pick_throw tasks; Brax and SB3 training
    in parallel populations; throw and bag-weight studies.
    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
    [base_black.stl, base_graphite.stl, base_orange.stl, fl_black.stl, fl_white.stl, fore_black.stl, fore_graphite.stl, fore_orange.stl]
